Barbatronic/Omni-RC-Robot/mcad/propulsion-arm-asm.FCStd

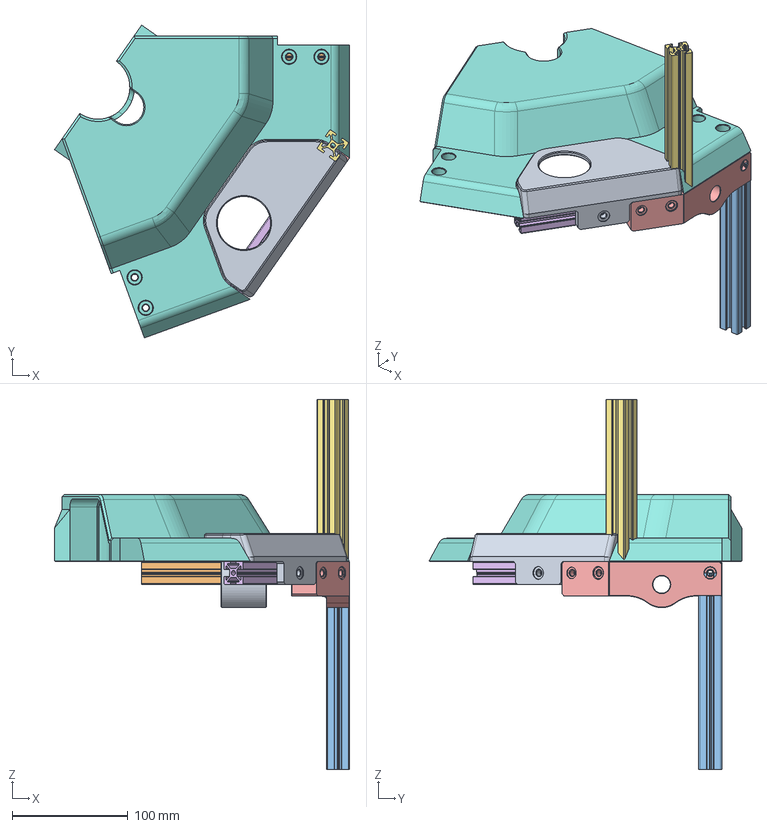
[picture p1: CAD file, 2026-11-05]
mcad/propulsion-arm-asm.FCStd
255.2 x 270.5 x 320.0 mm
motor-flange
Frame_Sketch005_Edge1
frame_Sketch005_Edge1
motor-bride
bearing-flange-link
Frame_Sketch038_Edge1
frame_Sketch038_Edge1
Carter
