Barbatronic/Omni-RC-Robot/mcad/aru-asm.FCStd

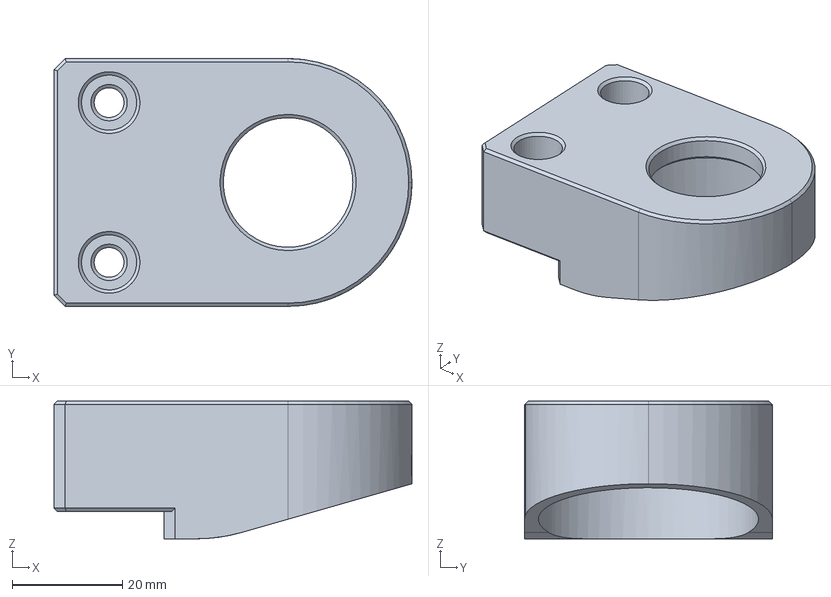
[picture p2: CAD file, 2026-11-05]
mcad/aru-asm.FCStd
65.0 x 45.0 x 25.0 mm
