Barbatronic/Omni-RC-Robot/mcad/propulsion-arm-asm-PièceCorps.3mf.step

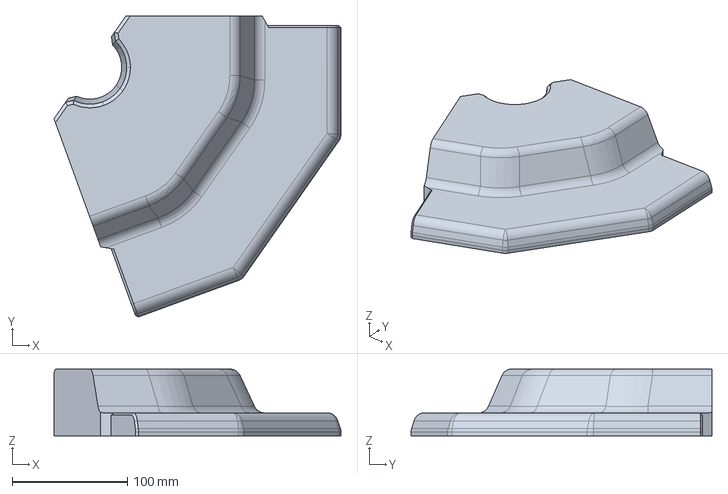
[picture p3: CAD file, 2026-11-05]
mcad/propulsion-arm-asm-PièceCorps.3mf.step
248.6 x 260.6 x 58.0 mm
