Barbatronic/Omni-RC-Robot/mcad/omni-rc-robot.FCStd

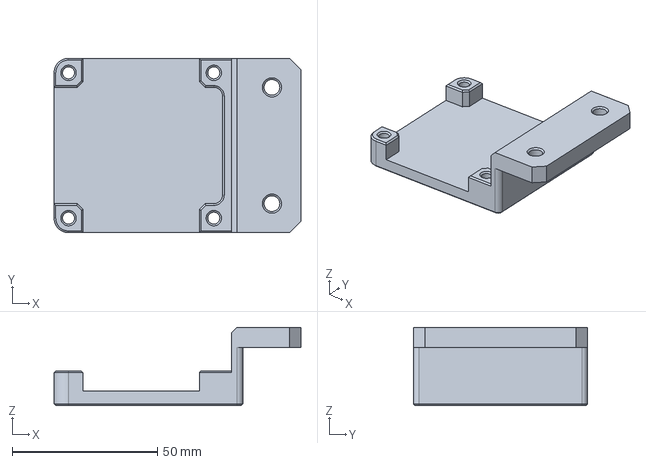
[picture p4: CAD file, 2026-11-05]
mcad/omni-rc-robot.FCStd
85.0 x 60.0 x 27.0 mm
