Barbatronic/Omni-RC-Robot/mcad/battery.FCStd

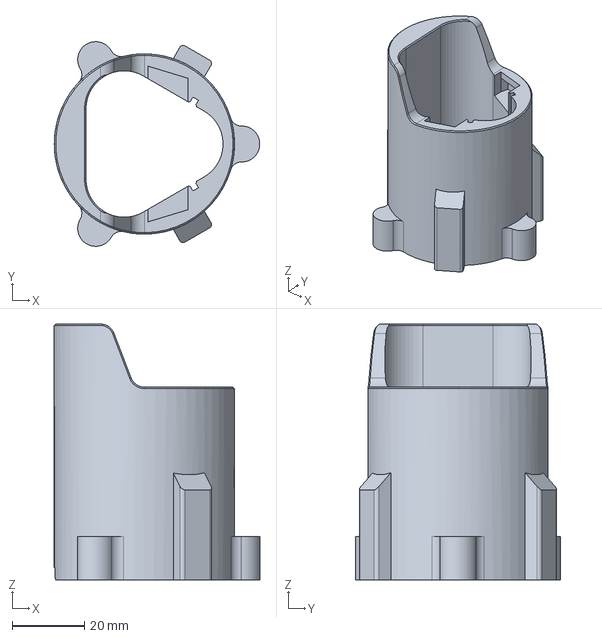
[picture p5: CAD file, 2026-11-05]
mcad/battery.FCStd
57.0 x 56.8 x 71.0 mm
