Barbatronic/Omni-RC-Robot/mcad/motor-hub.FCStd

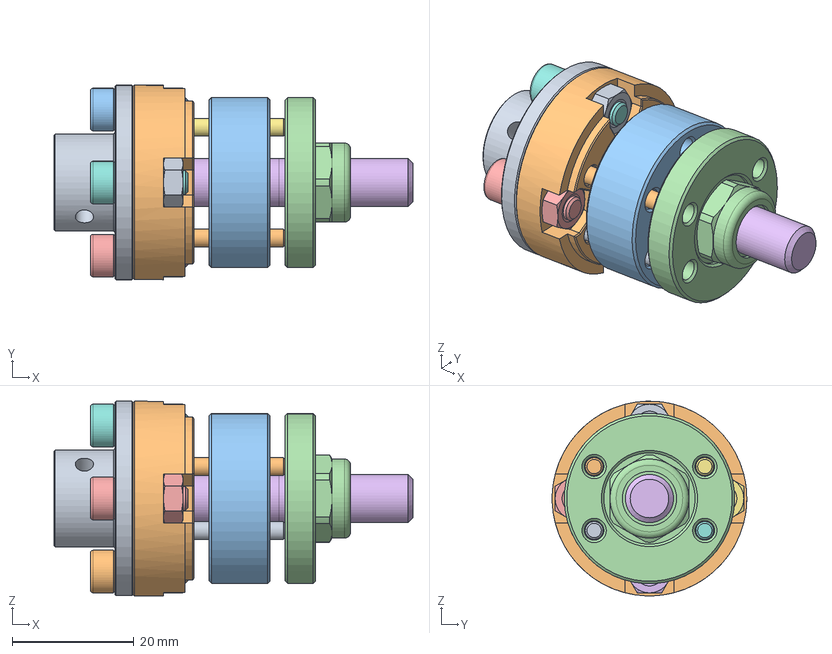
[picture p6: CAD file, 2026-11-05]
mcad/motor-hub.FCStd
59.0 x 32.0 x 32.0 mm
hub-8mm
Corps
Spacer
Corps001
M4x12-Vis002 x 2
M4-Écrous006 x 2
M4-Écrous004 x 2
M3x25-Vis008 x 2
M3x25-Vis007 x 2
M4x12-Vis003 x 2
M4x12-Vis x 2
M8-Écrous x 2
M4-Écrous005 x 2
M8x40-Vis x 2
M3x25-Vis009 x 2
M4x12-Vis001 x 2
M4-Écrous x 2
M3x25-Vis x 2
