Barbatronic/Omni-RC-Robot/mcad/omni-wheel.FCStd

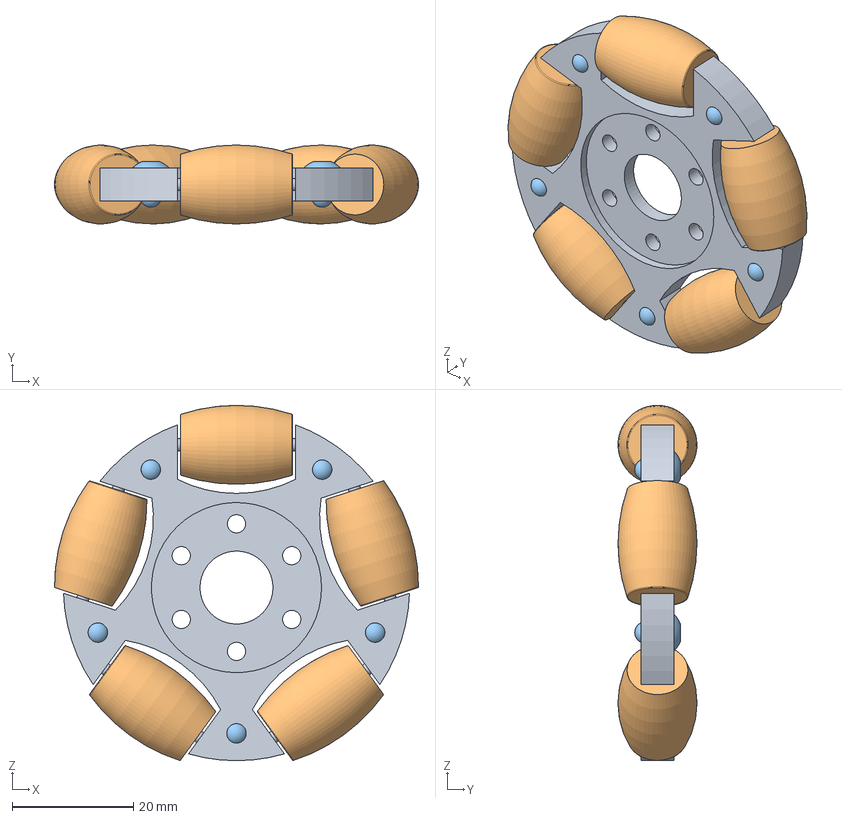
[picture p7: CAD file, 2026-11-05]
mcad/omni-wheel.FCStd
59.9 x 13.0 x 58.5 mm
MainPlate
Roller x 5
Rivet x 5
