Barbatronic/Omni-RC-Robot/mcad/motor-36GP-555.FCStd

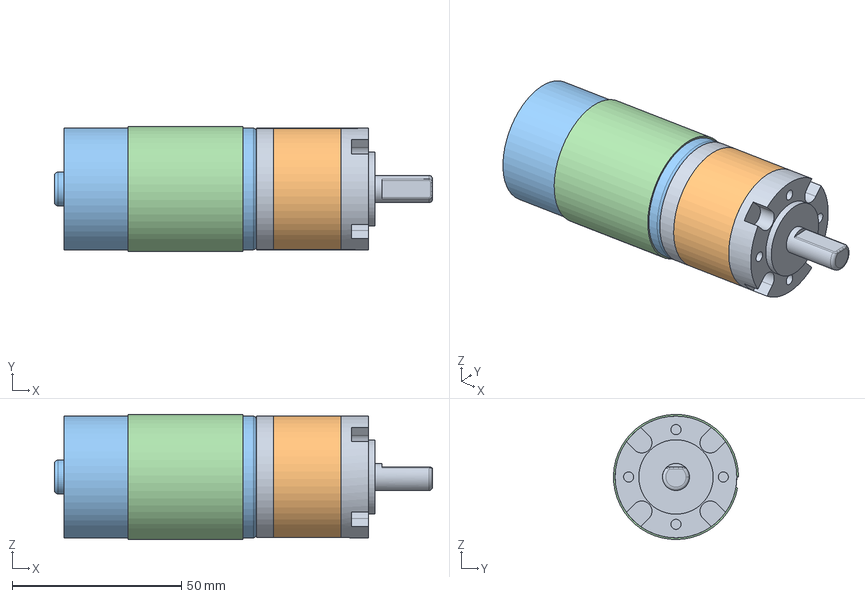
[picture p8: CAD file, 2026-11-05]
mcad/motor-36GP-555.FCStd
111.8 x 37.0 x 37.0 mm
Corps
Corps001
Corps002
Corps003
