Barbatronic/Omni-RC-Robot/mcad/support-BTS7960B.FCStd

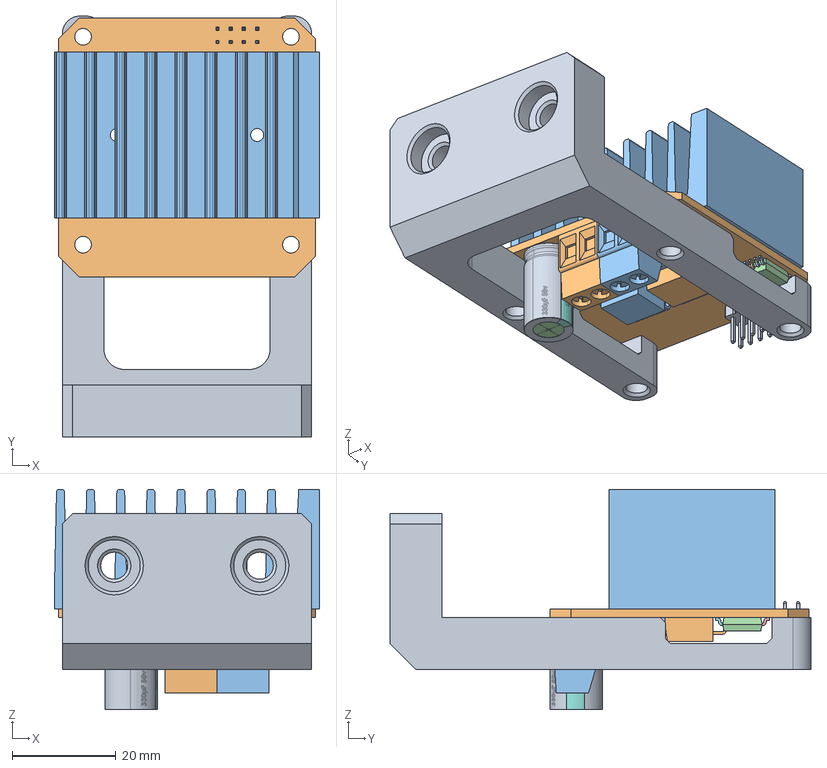
[picture p9: CAD file, 2026-11-05]
mcad/support-BTS7960B.FCStd
51.0 x 81.0 x 42.4 mm
support
PCB, BTS7960 43A HIGH POWER H BRIDGE MODULE
HEATSINK, BTS7960 43A HIGH POWER H BRIDGE MODULE
ALUMINUM ELECTROLYTIC CAPACITOR, 330 uF, BTS7960 43A HIGH POWER H BRIDGE MODULE
ALUMINUM ELECTROLYTIC CAPACITOR, 330 uF, BTS7960 43A HIGH POWER H BRIDGE MODULE001
ALUMINUM ELECTROLYTIC CAPACITOR, 330 uF, BTS7960 43A HIGH POWER H BRIDGE MODULE002
ALUMINUM ELECTROLYTIC CAPACITOR, 330 uF, BTS7960 43A HIGH POWER H BRIDGE MODULE003
ALUMINUM ELECTROLYTIC CAPACITOR, 330 uF, BTS7960 43A HIGH POWER H BRIDGE MODULE004
ALUMINUM ELECTROLYTIC CAPACITOR, 330 uF, BTS7960 43A HIGH POWER H BRIDGE MODULE005
BTN7960 IC, BTS7960 43A HIGH POWER H BRIDGE MODULE
BTN7960 IC, BTS7960 43A HIGH POWER H BRIDGE MODULE001
BTN7960 IC, BTS7960 43A HIGH POWER H BRIDGE MODULE002
BTN7960 IC, BTS7960 43A HIGH POWER H BRIDGE MODULE003
BTN7960 IC, BTS7960 43A HIGH POWER H BRIDGE MODULE004
BTN7960 IC, BTS7960 43A HIGH POWER H BRIDGE MODULE005
BTN7960 IC, BTS7960 43A HIGH POWER H BRIDGE MODULE006
BTN7960 IC, BTS7960 43A HIGH POWER H BRIDGE MODULE007
BTN7960 IC, BTS7960 43A HIGH POWER H BRIDGE MODULE008
BTN7960 IC, BTS7960 43A HIGH POWER H BRIDGE MODULE010
BTN7960 IC, BTS7960 43A HIGH POWER H BRIDGE MODULE011
BTN7960 IC, BTS7960 43A HIGH POWER H BRIDGE MODULE012
BTN7960 IC, BTS7960 43A HIGH POWER H BRIDGE MODULE013
BTN7960 IC, BTS7960 43A HIGH POWER H BRIDGE MODULE014
BTN7960 IC, BTS7960 43A HIGH POWER H BRIDGE MODULE015
BTN7960 IC, BTS7960 43A HIGH POWER H BRIDGE MODULE016
BTN7960 IC, BTS7960 43A HIGH POWER H BRIDGE MODULE017
BTN7960 IC, BTS7960 43A HIGH POWER H BRIDGE MODULE018
NXP 74HC244D, BUFFER AND LINE DRIVER, BTS7960 43A HIGH POWER H BRIDGE MODULE
NXP 74HC244D, BUFFER AND LINE DRIVER, BTS7960 43A HIGH POWER H BRIDGE MODULE001
NXP 74HC244D, BUFFER AND LINE DRIVER, BTS7960 43A HIGH POWER H BRIDGE MODULE002
NXP 74HC244D, BUFFER AND LINE DRIVER, BTS7960 43A HIGH POWER H BRIDGE MODULE003
NXP 74HC244D, BUFFER AND LINE DRIVER, BTS7960 43A HIGH POWER H BRIDGE MODULE004
NXP 74HC244D, BUFFER AND LINE DRIVER, BTS7960 43A HIGH POWER H BRIDGE MODULE005
NXP 74HC244D, BUFFER AND LINE DRIVER, BTS7960 43A HIGH POWER H BRIDGE MODULE006
NXP 74HC244D, BUFFER AND LINE DRIVER, BTS7960 43A HIGH POWER H BRIDGE MODULE007
NXP 74HC244D, BUFFER AND LINE DRIVER, BTS7960 43A HIGH POWER H BRIDGE MODULE008
NXP 74HC244D, BUFFER AND LINE DRIVER, BTS7960 43A HIGH POWER H BRIDGE MODULE009
NXP 74HC244D, BUFFER AND LINE DRIVER, BTS7960 43A HIGH POWER H BRIDGE MODULE010
NXP 74HC244D, BUFFER AND LINE DRIVER, BTS7960 43A HIGH POWER H BRIDGE MODULE011
NXP 74HC244D, BUFFER AND LINE DRIVER, BTS7960 43A HIGH POWER H BRIDGE MODULE012
NXP 74HC244D, BUFFER AND LINE DRIVER, BTS7960 43A HIGH POWER H BRIDGE MODULE013
NXP 74HC244D, BUFFER AND LINE DRIVER, BTS7960 43A HIGH POWER H BRIDGE MODULE014
NXP 74HC244D, BUFFER AND LINE DRIVER, BTS7960 43A HIGH POWER H BRIDGE MODULE015
NXP 74HC244D, BUFFER AND LINE DRIVER, BTS7960 43A HIGH POWER H BRIDGE MODULE016
NXP 74HC244D, BUFFER AND LINE DRIVER, BTS7960 43A HIGH POWER H BRIDGE MODULE017
NXP 74HC244D, BUFFER AND LINE DRIVER, BTS7960 43A HIGH POWER H BRIDGE MODULE018
NXP 74HC244D, BUFFER AND LINE DRIVER, BTS7960 43A HIGH POWER H BRIDGE MODULE019
NXP 74HC244D, BUFFER AND LINE DRIVER, BTS7960 43A HIGH POWER H BRIDGE MODULE020
8 PIN HEADER, IC, BTS7960 43A HIGH POWER H BRIDGE MODULE
EUROSTYLE TERMINAL BLOCK 2 POS 5.0 MM RA PLUG, BTS7960 43A HIGH POWER H BRIDGE MODULE
EUROSTYLE TERMINAL BLOCK 2 POS 5.0 MM RA PLUG, BTS7960 43A HIGH POWER H BRIDGE MODULE001
