Barbatronic/Omni-RC-Robot/ecad/omni-board/omni-board.kicad_pcb

## KiCad design ecad/omni-board/omni-board.kicad_pcb (2026-09-16)

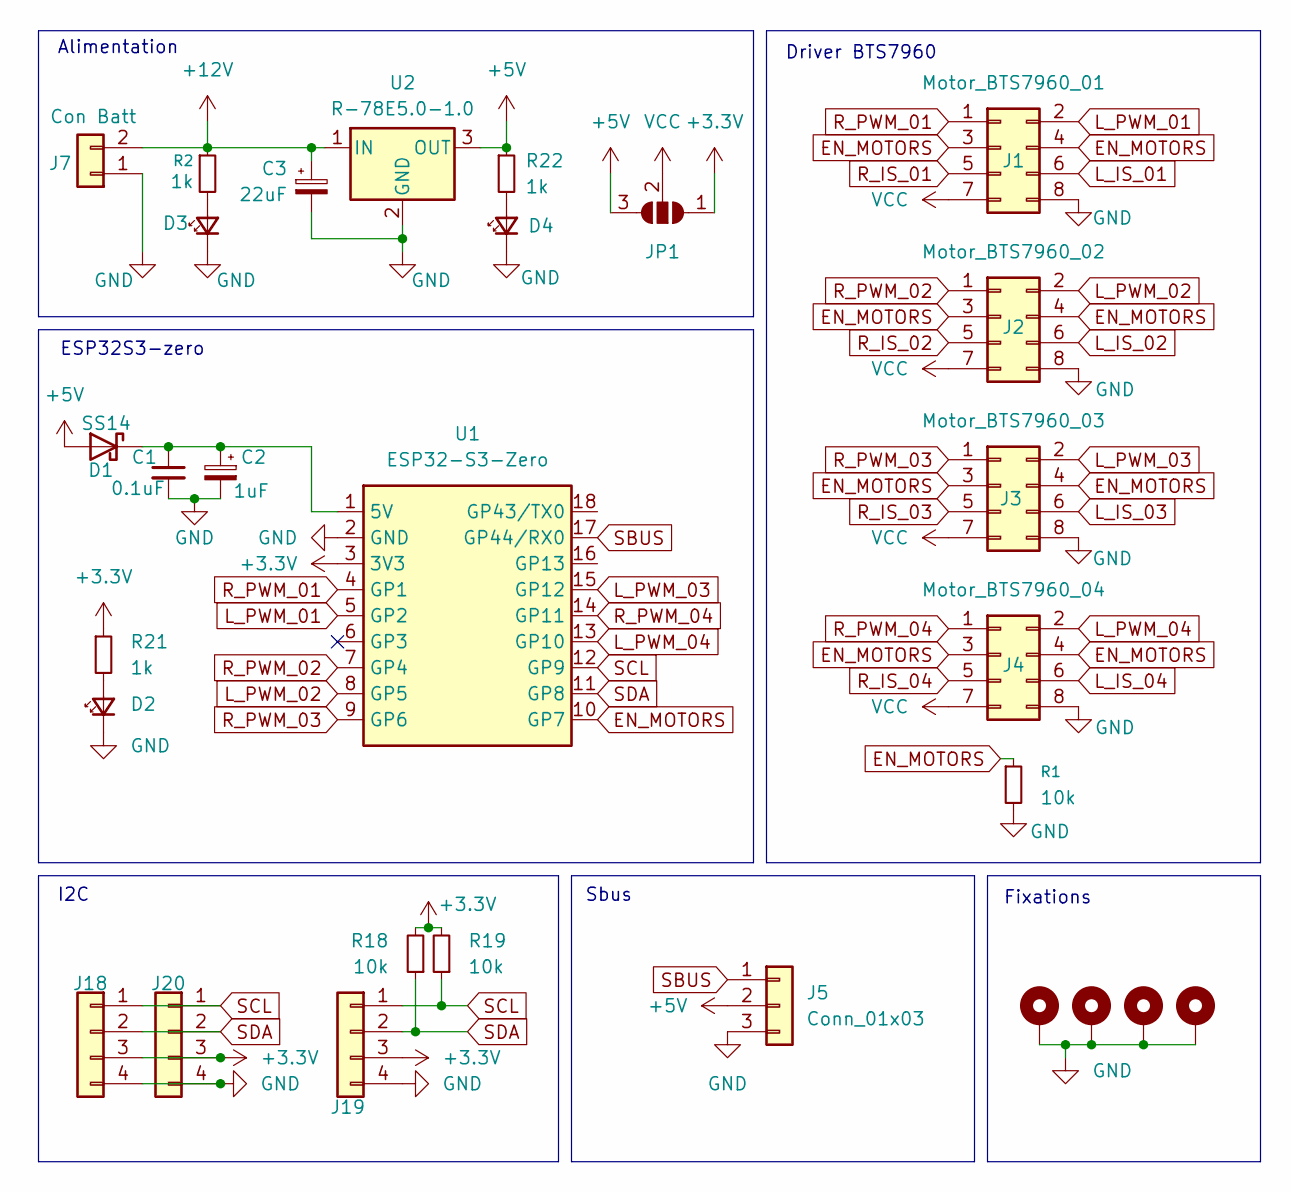
[picture p10: schematic omni-board.kicad_sch]

Parts:
C1: 0.1uF; C_1206_3216Metric_Pad1.33x1.80mm_HandSolder
C2: 1uF; CP_Elec_5x5.4
C3: 22uF; CP_Elec_5x5.4
D1: SS14; D_SMA_Handsoldering
D2, D3, D4: LED_Small; LED_1206_3216Metric_Pad1.42x1.75mm_HandSolder
H1, H2, H3, H4: MountingHole_Pad; MountingHole_3.2mm_M3_Pad_Via
J1: Motor_BTS7960_01; IDC-Header_2x04_P2.54mm_Vertical
J2: Motor_BTS7960_02; IDC-Header_2x04_P2.54mm_Vertical
J3: Motor_BTS7960_03; IDC-Header_2x04_P2.54mm_Vertical
J4: Motor_BTS7960_04; IDC-Header_2x04_P2.54mm_Vertical
J5: Conn_01x03; PinHeader_1x03_P2.54mm_Vertical
J7: Con Batt; AMASS_XT60-M_1x02_P7.20mm_Vertical
J18, J19, J20: Conn_01x04; Molex_KK-254_AE-6410-04A_1x04_P2.54mm_Vertical
JP1: SolderJumper_3_Open; SolderJumper-3_P2.0mm_Open_TrianglePad1.0x1.5mm
R1, R18, R19: 10k; R_1206_3216Metric_Pad1.30x1.75mm_HandSolder
R2, R21, R22: 1k; R_1206_3216Metric_Pad1.30x1.75mm_HandSolder
U1: ESP32-S3-Zero; ESP32-S3-Zero_THT; MPN ESP32-S3-Zero
U2: R-78E5.0-1.0; Converter_DCDC_RECOM_R-78E-0.5_THT

Connections:
+3.3V: J18.3, J19.3, J20.3, JP1.1 (A), R18.2, R19.2, R21.1, U1.3 (3V3)
+5V: D1.2 (A), J5.2, JP1.3 (B), R22.1, U2.3 (OUT)
+12V: C3.1, J7.2, R2.1, U2.1 (IN)
EN_MOTORS: J1.3, J1.4, J2.3, J2.4, J3.3, J3.4, J4.3, J4.4, R1.1, U1.10 (GP7)
GND: C1.2, C2.2, C3.2, D2.1 (K), D3.1 (K), D4.1 (K), H1.1 (1_1), H2.1 (1_1), H3.1 (1_1), H4.1 (1_1), J1.8, J2.8, J3.8, J4.8, J5.3, J7.1, J18.4, J19.4, J20.4, R1.2, U1.2 (GND), U2.2 (GND)
L_IS_01: J1.6
L_IS_02: J2.6
L_IS_03: J3.6
L_IS_04: J4.6
L_PWM_01: J1.2, U1.5 (GP2)
L_PWM_02: J2.2, U1.8 (GP5)
L_PWM_03: J3.2, U1.15 (GP12)
L_PWM_04: J4.2, U1.13 (GP10)
unnamed: C1.1, C2.1, D1.1 (K), U1.1 (5V)
unnamed: D2.2 (A), R21.2
unnamed: D3.2 (A), R2.2
unnamed: D4.2 (A), R22.2
R_IS_01: J1.5
R_IS_02: J2.5
R_IS_03: J3.5
R_IS_04: J4.5
R_PWM_01: J1.1, U1.4 (GP1)
R_PWM_02: J2.1, U1.7 (GP4)
R_PWM_03: J3.1, U1.9 (GP6)
R_PWM_04: J4.1, U1.14 (GP11)
SBUS: J5.1, U1.17 (GP44/RX0)
SCL: J18.1, J19.1, J20.1, R19.1, U1.12 (GP9)
SDA: J18.2, J19.2, J20.2, R18.1, U1.11 (GP8)
VCC: J1.7, J2.7, J3.7, J4.7, JP1.2 (C)

Notes on the sheet:
Fixations
Driver BTS7960
Sbus
ESP32S3-zero
Alimentation
I2C

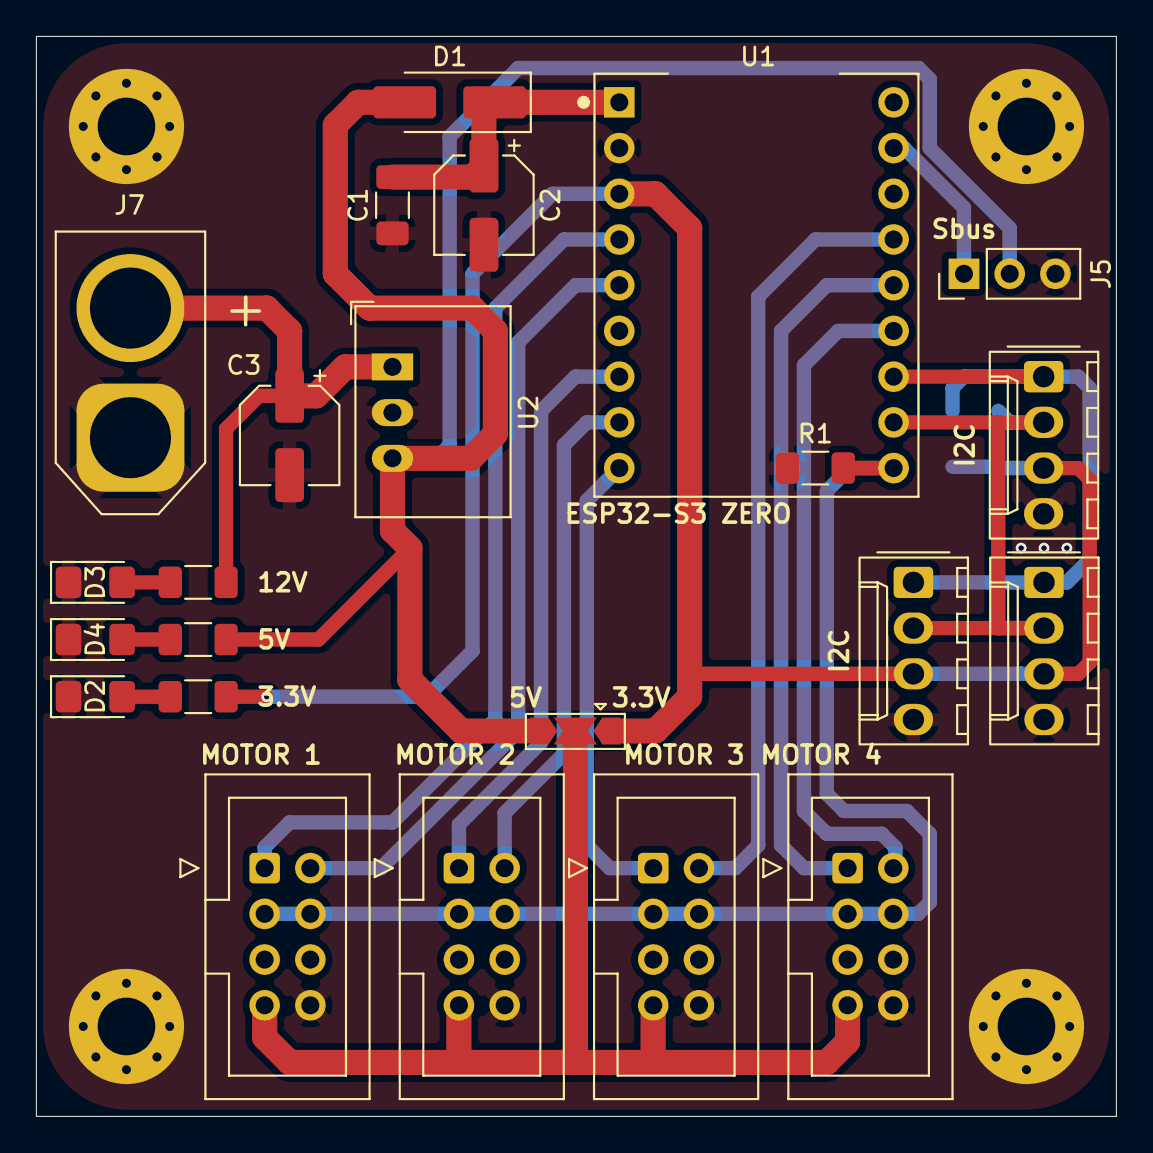
[picture p11: board omni-board.kicad_pcb from above]

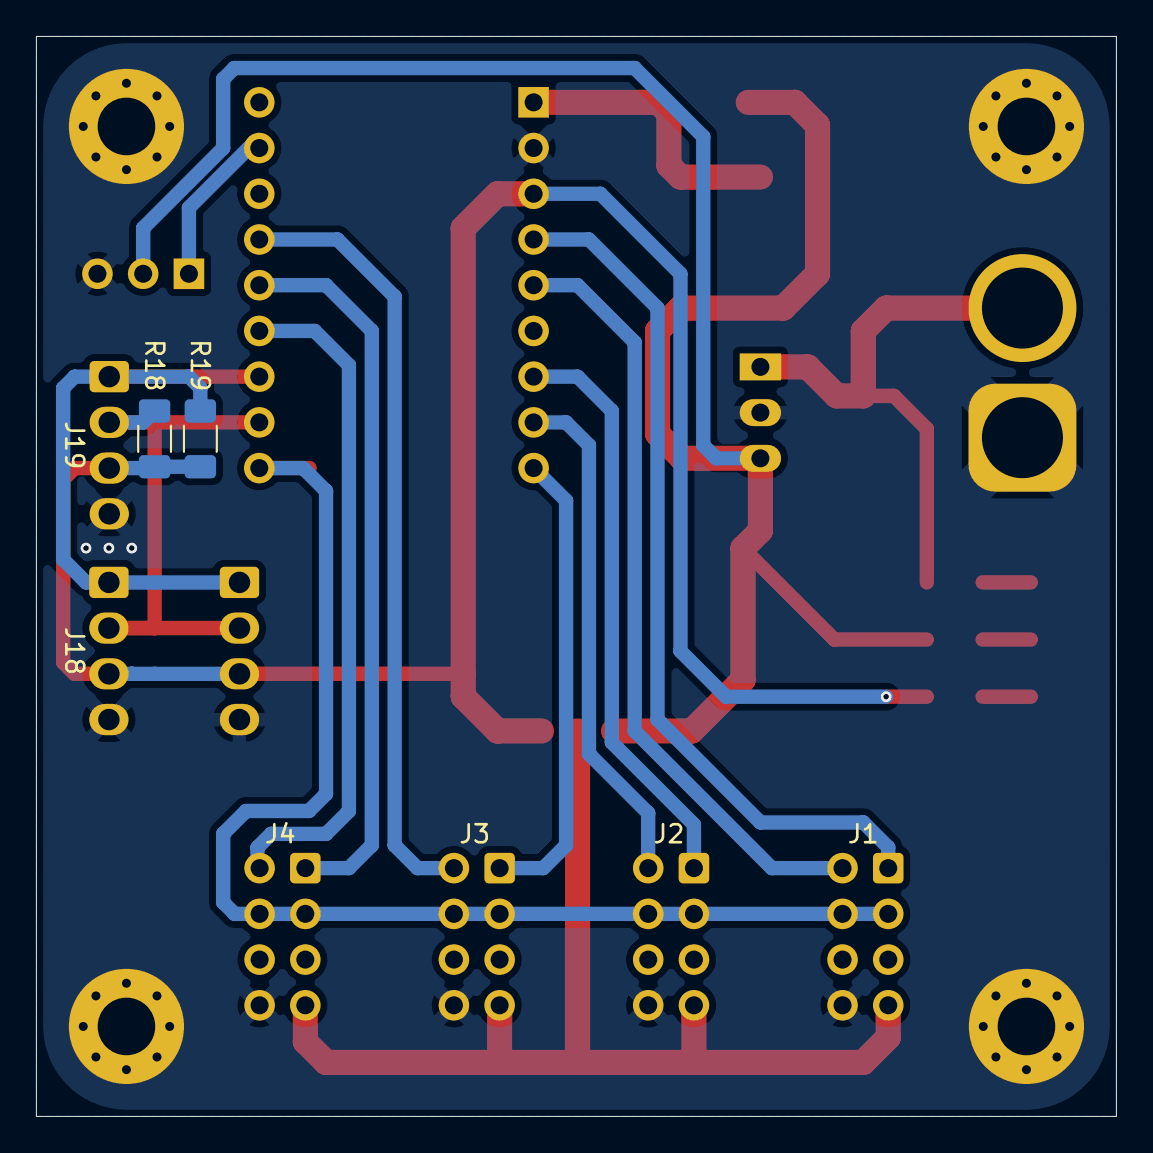
[picture p12: board omni-board.kicad_pcb from below]

Board: 2 copper layers, 60.0 x 60.0 mm, 29 parts (2 on the bottom side), 21 nets.
