Barbatronic/Omni-RC-Robot/mcad/.snapshots/motor-hub.yaml

v: 2
timestamp: '2026-08-29T11:19:20.004278'
uid: 6a041699-94d3-48be-af7a-7bac7a8adb73
objects:
- name: Body
  id: 1631
  type_id: PartDesign::Body
  properties:
    AllowCompound:
      kind: Primitive
      paths:
        .:
          type: BOOL
          value: true
      group: Base
    BaseFeature:
      kind: Primitive
      paths:
        .:
          type: 'NULL'
      group: Base
    Label:
      kind: Primitive
      paths:
        .:
          type: STRING
          value: hub-8mm
      group: Base
    Placement:
      kind: Placement
      paths:
        Base.x:
          type: QUANTITY
          value: 0.0 mm
        Base.y:
          type: QUANTITY
          value: 0.0 mm
        Base.z:
          type: QUANTITY
          value: 0.0 mm
        Rotation.Angle:
          type: QUANTITY
          value: 0.0 deg
        Rotation.Axis.x:
          type: FLOAT
          value: 0.0
        Rotation.Axis.y:
          type: FLOAT
          value: 0.0
        Rotation.Axis.z:
          type: FLOAT
          value: 1.0
      group: Base
    Tip:
      kind: Unknown
      paths:
        .:
          type: STRING
          value: <PartDesign::Chamfer>
          freecad_type: PartDesign.Feature
      group: Base
- name: Origin
  id: 1632
  type_id: App::Origin
  properties:
    Label:
      kind: Primitive
      paths:
        .:
          type: STRING
          value: Origine
      group: Base
- name: X_Axis
  id: 1633
  type_id: App::Line
  properties:
    Label:
      kind: Primitive
      paths:
        .:
          type: STRING
          value: Axe X
      group: Base
- name: Y_Axis
  id: 1634
  type_id: App::Line
  properties:
    Label:
      kind: Primitive
      paths:
        .:
          type: STRING
          value: Axe Y
      group: Base
- name: Z_Axis
  id: 1635
  type_id: App::Line
  properties:
    Label:
      kind: Primitive
      paths:
        .:
          type: STRING
          value: Axe Z
      group: Base
- name: XY_Plane
  id: 1636
  type_id: App::Plane
  properties:
    Label:
      kind: Primitive
      paths:
        .:
          type: STRING
          value: Plan XY
      group: Base
- name: XZ_Plane
  id: 1637
  type_id: App::Plane
  properties:
    Label:
      kind: Primitive
      paths:
        .:
          type: STRING
          value: Plan XZ
      group: Base
- name: YZ_Plane
  id: 1638
  type_id: App::Plane
  properties:
    Label:
      kind: Primitive
      paths:
        .:
          type: STRING
          value: Plan YZ
      group: Base
- name: Origin001
  id: 1639
  type_id: App::Point
  properties:
    Label:
      kind: Primitive
      paths:
        .:
          type: STRING
          value: Origine-point
      group: Base
- name: Sketch
  id: 1641
  type_id: Sketcher::SketchObject
  properties:
    ArcFitTolerance:
      kind: Primitive
      paths:
        .:
          type: FLOAT
          value: 1.0e-06
      group: Sketch
    AttacherEngine:
      kind: Primitive
      paths:
        .:
          type: STRING
          value: Engine Plane
      group: Attachment
    AttachmentOffset:
      kind: Placement
      paths:
        Base.x:
          type: QUANTITY
          value: 0.0 mm
        Base.y:
          type: QUANTITY
          value: 0.0 mm
        Base.z:
          type: QUANTITY
          value: 0.0 mm
        Rotation.Angle:
          type: QUANTITY
          value: 0.0 deg
        Rotation.Axis.x:
          type: FLOAT
          value: 0.0
        Rotation.Axis.y:
          type: FLOAT
          value: 0.0
        Rotation.Axis.z:
          type: FLOAT
          value: 1.0
      group: Attachment
    Constraints:
      kind: List
      paths: {}
      items:
      - kind: Constraint
        paths:
          Type:
            type: STRING
            value: PointOnObject
          Value:
            type: FLOAT
            value: 0.0
          First:
            type: INT
            value: 0
          FirstPos:
            type: INT
            value: 1
          Second:
            type: INT
            value: -1
          SecondPos:
            type: INT
            value: 0
          Third:
            type: INT
            value: -2000
          ThirdPos:
            type: INT
            value: 0
          Driving:
            type: BOOL
            value: true
          IsActive:
            type: BOOL
            value: true
      - kind: Constraint
        paths:
          Type:
            type: STRING
            value: Vertical
          Value:
            type: FLOAT
            value: 0.0
          First:
            type: INT
            value: 0
          FirstPos:
            type: INT
            value: 0
          Second:
            type: INT
            value: -2000
          SecondPos:
            type: INT
            value: 0
          Third:
            type: INT
            value: -2000
          ThirdPos:
            type: INT
            value: 0
          Driving:
            type: BOOL
            value: true
          IsActive:
            type: BOOL
            value: true
      - kind: Constraint
        paths:
          Type:
            type: STRING
            value: Coincident
          Value:
            type: FLOAT
            value: 0.0
          First:
            type: INT
            value: 0
          FirstPos:
            type: INT
            value: 2
          Second:
            type: INT
            value: 1
          SecondPos:
            type: INT
            value: 1
          Third:
            type: INT
            value: -2000
          ThirdPos:
            type: INT
            value: 0
          Driving:
            type: BOOL
            value: true
          IsActive:
            type: BOOL
            value: true
      - kind: Constraint
        paths:
          Type:
            type: STRING
            value: Horizontal
          Value:
            type: FLOAT
            value: 0.0
          First:
            type: INT
            value: 1
          FirstPos:
            type: INT
            value: 0
          Second:
            type: INT
            value: -2000
          SecondPos:
            type: INT
            value: 0
          Third:
            type: INT
            value: -2000
          ThirdPos:
            type: INT
            value: 0
          Driving:
            type: BOOL
            value: true
          IsActive:
            type: BOOL
            value: true
      - kind: Constraint
        paths:
          Type:
            type: STRING
            value: Coincident
          Value:
            type: FLOAT
            value: 0.0
          First:
            type: INT
            value: 1
          FirstPos:
            type: INT
            value: 2
          Second:
            type: INT
            value: 2
          SecondPos:
            type: INT
            value: 1
          Third:
            type: INT
            value: -2000
          ThirdPos:
            type: INT
            value: 0
          Driving:
            type: BOOL
            value: true
          IsActive:
            type: BOOL
            value: true
      - kind: Constraint
        paths:
          Type:
            type: STRING
            value: Vertical
          Value:
            type: FLOAT
            value: 0.0
          First:
            type: INT
            value: 2
          FirstPos:
            type: INT
            value: 0
          Second:
            type: INT
            value: -2000
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
            value: 0
          Driving:
            type: BOOL
            value: true
          IsActive:
            type: BOOL
            value: true
      group: Sketch
    Label:
      kind: Primitive
      paths:
        .:
          type: STRING
          value: Sketch
      group: Base
    MakeInternals:
      kind: Primitive
      paths:
        .:
          type: BOOL
          value: true
      group: Internal Geometry
    MapMode:
      kind: Primitive
      paths:
        .:
          type: STRING
          value: FlatFace
      group: Attachment
    MapReversed:
      kind: Primitive
      paths:
        .:
          type: BOOL
          value: false
      group: Attachment
    Placement:
      kind: Placement
      paths:
        Base.x:
          type: QUANTITY
          value: 0.0 mm
        Base.y:
          type: QUANTITY
          value: 0.0 mm
        Base.z:
          type: QUANTITY
          value: 0.0 mm
        Rotation.Angle:
          type: QUANTITY
          value: 90.0 deg
        Rotation.Axis.x:
          type: FLOAT
          value: 1.0
        Rotation.Axis.y:
          type: FLOAT
          value: 0.0
        Rotation.Axis.z:
          type: FLOAT
          value: 0.0
      group: Base
- name: Revolution
  id: 1642
  type_id: PartDesign::Revolution
  properties:
    AllowMultiFace:
      kind: Primitive
      paths:
        .:
          type: BOOL
          value: true
      group: SketchBased
    Angle:
      kind: Primitive
      paths:
        .:
          type: QUANTITY
          value: 360.0 deg
      group: Side1
    Angle2:
      kind: Primitive
      paths:
        .:
          type: QUANTITY
          value: 0.0 deg
      group: Side2
    FuzzyTolerance:
      kind: Primitive
      paths:
        .:
          type: FLOAT
          value: 0.0
      group: Part Design
    Label:
      kind: Primitive
      paths:
        .:
          type: STRING
          value: Revolution
      group: Base
    Midplane:
      kind: Primitive
      paths:
        .:
          type: BOOL
          value: false
      group: SketchBased
    Profile:
      kind: List
      paths: {}
      items:
      - kind: Unknown
        paths:
          .:
            type: STRING
            value: <Sketcher::SketchObject>
            freecad_type: Sketcher.SketchObject
      - kind: List
        paths: {}
        items:
        - kind: Primitive
          paths:
            .:
              type: STRING
              value: ''
      group: SketchBased
    ReferenceAxis:
      kind: List
      paths: {}
      items:
      - kind: Unknown
        paths:
          .:
            type: STRING
            value: <Sketcher::SketchObject>
            freecad_type: Sketcher.SketchObject
      - kind: List
        paths: {}
        items:
        - kind: Primitive
          paths:
            .:
              type: STRING
              value: H_Axis
      group: Revolution
    Refine:
      kind: Primitive
      paths:
        .:
          type: BOOL
          value: true
      group: Part Design
    Reversed:
      kind: Primitive
      paths:
        .:
          type: BOOL
          value: false
      group: SketchBased
    SideType:
      kind: Primitive
      paths:
        .:
          type: STRING
          value: One side
      group: Revolution
    Suppressed:
      kind: Primitive
      paths:
        .:
          type: BOOL
          value: false
      group: Base
    Type:
      kind: Primitive
      paths:
        .:
          type: STRING
          value: Angle
      group: Side1
    Type2:
      kind: Primitive
      paths:
        .:
          type: STRING
          value: Angle
      group: Side2
    UpToFace:
      kind: Primitive
      paths:
        .:
          type: 'NULL'
      group: Side1
    UpToFace2:
      kind: Primitive
      paths:
        .:
          type: 'NULL'
      group: Side2
- name: Sketch001
  id: 1643
  type_id: Sketcher::SketchObject
  properties:
    ArcFitTolerance:
      kind: Primitive
      paths:
        .:
          type: FLOAT
          value: 1.0e-06
      group: Sketch
    AttacherEngine:
      kind: Primitive
      paths:
        .:
          type: STRING
          value: Engine Plane
      group: Attachment
    AttachmentOffset:
      kind: Placement
      paths:
        Base.x:
          type: QUANTITY
          value: 0.0 mm
        Base.y:
          type: QUANTITY
          value: 0.0 mm
        Base.z:
          type: QUANTITY
          value: 0.0 mm
        Rotation.Angle:
          type: QUANTITY
          value: 0.0 deg
        Rotation.Axis.x:
          type: FLOAT
          value: 0.0
        Rotation.Axis.y:
          type: FLOAT
          value: 0.0
        Rotation.Axis.z:
          type: FLOAT
          value: 1.0
      group: Attachment
    Constraints:
      kind: List
      paths: {}
      items:
      - kind: Constraint
        paths:
          Type:
            type: STRING
            value: PointOnObject
          Value:
            type: FLOAT
            value: 0.0
          First:
            type: INT
            value: 0
          FirstPos:
            type: INT
            value: 3
          Second:
            type: INT
            value: -2
          SecondPos:
            type: INT
            value: 0
          Third:
            type: INT
            value: -2000
          ThirdPos:
            type: INT
            value: 0
          Driving:
            type: BOOL
            value: true
          IsActive:
            type: BOOL
            value: true
      - kind: Constraint
        paths:
          Type:
            type: STRING
            value: Diameter
          Value:
            type: FLOAT
            value: 4.0
          First:
            type: INT
            value: 0
          FirstPos:
            type: INT
            value: 0
          Second:
            type: INT
            value: -2000
          SecondPos:
            type: INT
            value: 0
          Third:
            type: INT
            value: -2000
          ThirdPos:
            type: INT
            value: 0
          Driving:
            type: BOOL
            value: true
          IsActive:
            type: BOOL
            value: true
      - kind: Constraint
        paths:
          Type:
            type: STRING
            value: DistanceY
          Value:
            type: FLOAT
            value: 12.0
          First:
            type: INT
            value: -1
          FirstPos:
            type: INT
            value: 1
          Second:
            type: INT
            value: 0
          SecondPos:
            type: INT
            value: 3
          Third:
            type: INT
            value: -2000
          ThirdPos:
            type: INT
            value: 0
          Driving:
            type: BOOL
            value: true
          IsActive:
            type: BOOL
            value: true
      group: Sketch
    Label:
      kind: Primitive
      paths:
        .:
          type: STRING
          value: Sketch001
      group: Base
    MakeInternals:
      kind: Primitive
      paths:
        .:
          type: BOOL
          value: true
      group: Internal Geometry
    MapMode:
      kind: Primitive
      paths:
        .:
          type: STRING
          value: FlatFace
      group: Attachment
    MapReversed:
      kind: Primitive
      paths:
        .:
          type: BOOL
          value: false
      group: Attachment
    Placement:
      kind: Placement
      paths:
        Base.x:
          type: QUANTITY
          value: 0.0 mm
        Base.y:
          type: QUANTITY
          value: 0.0 mm
        Base.z:
          type: QUANTITY
          value: 0.0 mm
        Rotation.Angle:
          type: QUANTITY
          value: 120.00000000000001 deg
        Rotation.Axis.x:
          type: FLOAT
          value: 0.5773502691896257
        Rotation.Axis.y:
          type: FLOAT
          value: 0.5773502691896257
        Rotation.Axis.z:
          type: FLOAT
          value: 0.5773502691896257
      group: Base
- name: Pocket
  id: 1644
  type_id: PartDesign::Pocket
  properties:
    AllowMultiFace:
      kind: Primitive
      paths:
        .:
          type: BOOL
          value: true
      group: SketchBased
    AlongSketchNormal:
      kind: Primitive
      paths:
        .:
          type: BOOL
          value: true
      group: Pocket
    FuzzyTolerance:
      kind: Primitive
      paths:
        .:
          type: FLOAT
          value: 0.0
      group: Part Design
    Label:
      kind: Primitive
      paths:
        .:
          type: STRING
          value: Pocket
      group: Base
    Length:
      kind: Primitive
      paths:
        .:
          type: QUANTITY
          value: 5.0 mm
      group: Side1
    Length2:
      kind: Primitive
      paths:
        .:
          type: QUANTITY
          value: 5.0 mm
      group: Side2
    Midplane:
      kind: Primitive
      paths:
        .:
          type: BOOL
          value: false
      group: SketchBased
    Offset:
      kind: Primitive
      paths:
        .:
          type: QUANTITY
          value: 0.0 mm
      group: Side1
    Offset2:
      kind: Primitive
      paths:
        .:
          type: QUANTITY
          value: 0.0 mm
      group: Side2
    Profile:
      kind: List
      paths: {}
      items:
      - kind: Unknown
        paths:
          .:
            type: STRING
            value: <Sketcher::SketchObject>
            freecad_type: Sketcher.SketchObject
      - kind: List
        paths: {}
        items:
        - kind: Primitive
          paths:
            .:
              type: STRING
              value: ''
      group: SketchBased
    ReferenceAxis:
      kind: List
      paths: {}
      items:
      - kind: Unknown
        paths:
          .:
            type: STRING
            value: <Sketcher::SketchObject>
            freecad_type: Sketcher.SketchObject
      - kind: List
        paths: {}
        items:
        - kind: Primitive
          paths:
            .:
              type: STRING
              value: N_Axis
      group: Pocket
    Refine:
      kind: Primitive
      paths:
        .:
          type: BOOL
          value: true
      group: Part Design
    Reversed:
      kind: Primitive
      paths:
        .:
          type: BOOL
          value: false
      group: SketchBased
    SideType:
      kind: Primitive
      paths:
        .:
          type: STRING
          value: One side
      group: Pocket
    StartOffset:
      kind: Primitive
      paths:
        .:
          type: QUANTITY
          value: 0.0 mm
      group: Start
    StartReference:
      kind: Primitive
      paths:
        .:
          type: 'NULL'
      group: Start
    StartType:
      kind: Primitive
      paths:
        .:
          type: STRING
          value: Profile plane
      group: Start
    Suppressed:
      kind: Primitive
      paths:
        .:
          type: BOOL
          value: false
      group: Base
    TaperAngle:
      kind: Primitive
      paths:
        .:
          type: QUANTITY
          value: 0.0 deg
      group: Side1
    TaperAngle2:
      kind: Primitive
      paths:
        .:
          type: QUANTITY
          value: 0.0 deg
      group: Side2
    Type:
      kind: Primitive
      paths:
        .:
          type: STRING
          value: Length
      group: Side1
    Type2:
      kind: Primitive
      paths:
        .:
          type: STRING
          value: Length
      group: Side2
    UpToFace:
      kind: Primitive
      paths:
        .:
          type: 'NULL'
      group: Side1
    UpToFace2:
      kind: Primitive
      paths:
        .:
          type: 'NULL'
      group: Side2
    UseCustomVector:
      kind: Primitive
      paths:
        .:
          type: BOOL
          value: false
      group: Pocket
- name: PolarPattern
  id: 1645
  type_id: PartDesign::PolarPattern
  properties:
    Angle:
      kind: Primitive
      paths:
        .:
          type: QUANTITY
          value: 360.0 deg
      group: PolarPattern
    Axis:
      kind: List
      paths: {}
      items:
      - kind: Unknown
        paths:
          .:
            type: STRING
            value: <Sketcher::SketchObject>
            freecad_type: Sketcher.SketchObject
      - kind: List
        paths: {}
        items:
        - kind: Primitive
          paths:
            .:
              type: STRING
              value: N_Axis
      group: PolarPattern
    FuzzyTolerance:
      kind: Primitive
      paths:
        .:
          type: FLOAT
          value: 0.0
      group: Part Design
    Label:
      kind: Primitive
      paths:
        .:
          type: STRING
          value: PolarPattern
      group: Base
    Mode:
      kind: Primitive
      paths:
        .:
          type: STRING
          value: Extent
      group: PolarPattern
    Occurrences:
      kind: Primitive
      paths:
        .:
          type: INT
          value: 4
      group: PolarPattern
    Offset:
      kind: Primitive
      paths:
        .:
          type: QUANTITY
          value: 120.0 deg
      group: PolarPattern
    Refine:
      kind: Primitive
      paths:
        .:
          type: BOOL
          value: true
      group: Part Design
    Reversed:
      kind: Primitive
      paths:
        .:
          type: BOOL
          value: false
      group: PolarPattern
    Suppressed:
      kind: Primitive
      paths:
        .:
          type: BOOL
          value: false
      group: Base
    TransformMode:
      kind: Primitive
      paths:
        .:
          type: STRING
          value: Features
      group: Base
- name: Sketch002
  id: 1646
  type_id: Sketcher::SketchObject
  properties:
    ArcFitTolerance:
      kind: Primitive
      paths:
        .:
          type: FLOAT
          value: 1.0e-06
      group: Sketch
    AttacherEngine:
      kind: Primitive
      paths:
        .:
          type: STRING
          value: Engine Plane
      group: Attachment
    AttachmentOffset:
      kind: Placement
      paths:
        Base.x:
          type: QUANTITY
          value: 0.0 mm
        Base.y:
          type: QUANTITY
          value: 0.0 mm
        Base.z:
          type: QUANTITY
          value: 0.0 mm
        Rotation.Angle:
          type: QUANTITY
          value: 45.00000000000001 deg
        Rotation.Axis.x:
          type: FLOAT
          value: 1.0
        Rotation.Axis.y:
          type: FLOAT
          value: 0.0
        Rotation.Axis.z:
          type: FLOAT
          value: 0.0
      group: Attachment
    Constraints:
      kind: List
      paths: {}
      items:
      - kind: Constraint
        paths:
          Type:
            type: STRING
            value: PointOnObject
          Value:
            type: FLOAT
            value: 0.0
          First:
            type: INT
            value: 0
          FirstPos:
            type: INT
            value: 3
          Second:
            type: INT
            value: -1
          SecondPos:
            type: INT
            value: 0
          Third:
            type: INT
            value: -2000
          ThirdPos:
            type: INT
            value: 0
          Driving:
            type: BOOL
            value: true
          IsActive:
            type: BOOL
            value: true
      - kind: Constraint
        paths:
          Type:
            type: STRING
            value: Distance
          Value:
            type: FLOAT
            value: 5.0
          First:
            type: INT
            value: 0
          FirstPos:
            type: INT
            value: 3
          Second:
            type: INT
            value: -3
          SecondPos:
            type: INT
            value: 0
          Third:
            type: INT
            value: -2000
          ThirdPos:
            type: INT
            value: 0
          Driving:
            type: BOOL
            value: true
          IsActive:
            type: BOOL
            value: true
      - kind: Constraint
        paths:
          Type:
            type: STRING
            value: Diameter
          Value:
            type: FLOAT
            value: 3.0
          First:
            type: INT
            value: 0
          FirstPos:
            type: INT
            value: 0
          Second:
            type: INT
            value: -2000
          SecondPos:
            type: INT
            value: 0
          Third:
            type: INT
            value: -2000
          ThirdPos:
            type: INT
            value: 0
          Driving:
            type: BOOL
            value: true
          IsActive:
            type: BOOL
            value: true
      group: Sketch
    Label:
      kind: Primitive
      paths:
        .:
          type: STRING
          value: Sketch002
      group: Base
    MakeInternals:
      kind: Primitive
      paths:
        .:
          type: BOOL
          value: true
      group: Internal Geometry
    MapMode:
      kind: Primitive
      paths:
        .:
          type: STRING
          value: FlatFace
      group: Attachment
    MapReversed:
      kind: Primitive
      paths:
        .:
          type: BOOL
          value: false
      group: Attachment
    Placement:
      kind: Placement
      paths:
        Base.x:
          type: QUANTITY
          value: 0.0 mm
        Base.y:
          type: QUANTITY
          value: 0.0 mm
        Base.z:
          type: QUANTITY
          value: 0.0 mm
        Rotation.Angle:
          type: QUANTITY
          value: 45.00000000000001 deg
        Rotation.Axis.x:
          type: FLOAT
          value: 1.0
        Rotation.Axis.y:
          type: FLOAT
          value: 0.0
        Rotation.Axis.z:
          type: FLOAT
          value: 0.0
      group: Base
- name: Pocket001
  id: 1647
  type_id: PartDesign::Pocket
  properties:
    AllowMultiFace:
      kind: Primitive
      paths:
        .:
          type: BOOL
          value: true
      group: SketchBased
    AlongSketchNormal:
      kind: Primitive
      paths:
        .:
          type: BOOL
          value: true
      group: Pocket
    FuzzyTolerance:
      kind: Primitive
      paths:
        .:
          type: FLOAT
          value: 0.0
      group: Part Design
    Label:
      kind: Primitive
      paths:
        .:
          type: STRING
          value: Pocket001
      group: Base
    Length:
      kind: Primitive
      paths:
        .:
          type: QUANTITY
          value: 20.0 mm
      group: Side1
    Length2:
      kind: Primitive
      paths:
        .:
          type: QUANTITY
          value: 5.0 mm
      group: Side2
    Midplane:
      kind: Primitive
      paths:
        .:
          type: BOOL
          value: false
      group: SketchBased
    Offset:
      kind: Primitive
      paths:
        .:
          type: QUANTITY
          value: 0.0 mm
      group: Side1
    Offset2:
      kind: Primitive
      paths:
        .:
          type: QUANTITY
          value: 0.0 mm
      group: Side2
    Profile:
      kind: List
      paths: {}
      items:
      - kind: Unknown
        paths:
          .:
            type: STRING
            value: <Sketcher::SketchObject>
            freecad_type: Sketcher.SketchObject
      - kind: List
        paths: {}
        items:
        - kind: Primitive
          paths:
            .:
              type: STRING
              value: ''
      group: SketchBased
    ReferenceAxis:
      kind: List
      paths: {}
      items:
      - kind: Unknown
        paths:
          .:
            type: STRING
            value: <Sketcher::SketchObject>
            freecad_type: Sketcher.SketchObject
      - kind: List
        paths: {}
        items:
        - kind: Primitive
          paths:
            .:
              type: STRING
              value: N_Axis
      group: Pocket
    Refine:
      kind: Primitive
      paths:
        .:
          type: BOOL
          value: true
      group: Part Design
    Reversed:
      kind: Primitive
      paths:
        .:
          type: BOOL
          value: false
      group: SketchBased
    SideType:
      kind: Primitive
      paths:
        .:
          type: STRING
          value: Symmetric
      group: Pocket
    StartOffset:
      kind: Primitive
      paths:
        .:
          type: QUANTITY
          value: 0.0 mm
      group: Start
    StartReference:
      kind: Primitive
      paths:
        .:
          type: 'NULL'
      group: Start
    StartType:
      kind: Primitive
      paths:
        .:
          type: STRING
          value: Profile plane
      group: Start
    Suppressed:
      kind: Primitive
      paths:
        .:
          type: BOOL
          value: false
      group: Base
    TaperAngle:
      kind: Primitive
      paths:
        .:
          type: QUANTITY
          value: 0.0 deg
      group: Side1
    TaperAngle2:
      kind: Primitive
      paths:
        .:
          type: QUANTITY
          value: 0.0 deg
      group: Side2
    Type:
      kind: Primitive
      paths:
        .:
          type: STRING
          value: Length
      group: Side1
    Type2:
      kind: Primitive
      paths:
        .:
          type: STRING
          value: Length
      group: Side2
    UpToFace:
      kind: Primitive
      paths:
        .:
          type: 'NULL'
      group: Side1
    UpToFace2:
      kind: Primitive
      paths:
        .:
          type: 'NULL'
      group: Side2
    UseCustomVector:
      kind: Primitive
      paths:
        .:
          type: BOOL
          value: false
      group: Pocket
- name: Chamfer
  id: 1648
  type_id: PartDesign::Chamfer
  properties:
    Angle:
      kind: Primitive
      paths:
        .:
          type: QUANTITY
          value: 45.0 deg
      group: Chamfer
    Base:
      kind: List
      paths: {}
      items:
      - kind: Unknown
        paths:
          .:
            type: STRING
            value: <PartDesign::Pocket>
            freecad_type: PartDesign.Feature
      - kind: List
        paths: {}
        items:
        - kind: Primitive
          paths:
            .:
              type: STRING
              value: Edge6
        - kind: Primitive
          paths:
            .:
              type: STRING
              value: Edge16
        - kind: Primitive
          paths:
            .:
              type: STRING
              value: Edge3
        - kind: Primitive
          paths:
            .:
              type: STRING
              value: Edge2
        - kind: Primitive
          paths:
            .:
              type: STRING
              value: Edge9
        - kind: Primitive
          paths:
            .:
              type: STRING
              value: Edge7
        - kind: Primitive
          paths:
            .:
              type: STRING
              value: Edge10
        - kind: Primitive
          paths:
            .:
              type: STRING
              value: Edge8
        - kind: Primitive
          paths:
            .:
              type: STRING
              value: Edge20
        - kind: Primitive
          paths:
            .:
              type: STRING
              value: Edge24
        - kind: Primitive
          paths:
            .:
              type: STRING
              value: Edge22
        - kind: Primitive
          paths:
            .:
              type: STRING
              value: Edge18
        - kind: Primitive
          paths:
            .:
              type: STRING
              value: Edge27
        - kind: Primitive
          paths:
            .:
              type: STRING
              value: Edge11
      group: Base
    ChamferType:
      kind: Primitive
      paths:
        .:
          type: STRING
          value: Equal distance
      group: Chamfer
    FlipDirection:
      kind: Primitive
      paths:
        .:
          type: BOOL
          value: false
      group: Chamfer
    FuzzyTolerance:
      kind: Primitive
      paths:
        .:
          type: FLOAT
          value: 0.0
      group: Part Design
    Label:
      kind: Primitive
      paths:
        .:
          type: STRING
          value: Chamfer
      group: Base
    Refine:
      kind: Primitive
      paths:
        .:
          type: BOOL
          value: true
      group: Part Design
    Size:
      kind: Primitive
      paths:
        .:
          type: QUANTITY
          value: 0.2 mm
      group: Chamfer
    Size2:
      kind: Primitive
      paths:
        .:
          type: QUANTITY
          value: 1.0 mm
      group: Chamfer
    SupportTransform:
      kind: Primitive
      paths:
        .:
          type: BOOL
          value: false
      group: Base
    Suppressed:
      kind: Primitive
      paths:
        .:
          type: BOOL
          value: false
      group: Base
    UseAllEdges:
      kind: Primitive
      paths:
        .:
          type: BOOL
          value: false
      group: Chamfer
occurrences:
- path: Body
  after: null
- path: Body/Chamfer
  after: Body/Pocket001
- path: Body/Origin
  after: null
- path: Body/Origin/Origin001
  after: Body/Origin/YZ_Plane
- path: Body/Origin/XY_Plane
  after: Body/Origin/Z_Axis
- path: Body/Origin/XZ_Plane
  after: Body/Origin/XY_Plane
- path: Body/Origin/X_Axis
  after: null
- path: Body/Origin/YZ_Plane
  after: Body/Origin/XZ_Plane
- path: Body/Origin/Y_Axis
  after: Body/Origin/X_Axis
- path: Body/Origin/Z_Axis
  after: Body/Origin/Y_Axis
- path: Body/Pocket
  after: Body/Revolution
- path: Body/Pocket/Sketch001
  after: null
- path: Body/Pocket001
  after: Body/PolarPattern
- path: Body/Pocket001/Sketch002
  after: null
- path: Body/PolarPattern
  after: Body/Pocket
- path: Body/Revolution
  after: Body/Origin
- path: Body/Revolution/Sketch
  after: null
