Barbatronic/Omni-RC-Robot/mcad/.snapshots/omni-wheel.yaml

v: 2
timestamp: '2026-08-29T11:19:20.040773'
uid: 079c154c-ae16-4f54-8fc6-bfcc7b306ea5
objects:
- name: Body047
  id: 4119
  type_id: PartDesign::Body
  properties:
    AllowCompound:
      kind: Primitive
      paths:
        .:
          type: BOOL
          value: true
      group: Base
    BaseFeature:
      kind: Primitive
      paths:
        .:
          type: 'NULL'
      group: Base
    Label:
      kind: Primitive
      paths:
        .:
          type: STRING
          value: MainPlate
      group: Base
    Placement:
      kind: Placement
      paths:
        Base.x:
          type: QUANTITY
          value: 0.0 mm
        Base.y:
          type: QUANTITY
          value: 0.0 mm
        Base.z:
          type: QUANTITY
          value: 0.0 mm
        Rotation.Angle:
          type: QUANTITY
          value: 0.0 deg
        Rotation.Axis.x:
          type: FLOAT
          value: 0.0
        Rotation.Axis.y:
          type: FLOAT
          value: 0.0
        Rotation.Axis.z:
          type: FLOAT
          value: 1.0
      group: Base
    Tip:
      kind: Unknown
      paths:
        .:
          type: STRING
          value: <PartDesign::PolarPattern>
          freecad_type: PartDesign.Feature
      group: Base
- name: Body050
  id: 4120
  type_id: PartDesign::Body
  properties:
    AllowCompound:
      kind: Primitive
      paths:
        .:
          type: BOOL
          value: true
      group: Base
    BaseFeature:
      kind: Primitive
      paths:
        .:
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
        Rotation.Angle:
          type: QUANTITY
          value: 180.0 deg
        Rotation.Axis.x:
          type: FLOAT
          value: 0.0
        Rotation.Axis.y:
          type: FLOAT
          value: 0.7071067811865476
        Rotation.Axis.z:
          type: FLOAT
          value: 0.7071067811865475
      group: Base
    ResizeMode:
      kind: Primitive
      paths:
        .:
          type: STRING
          value: Automatic
      group: Size
- name: Fillet029
  id: 4124
  type_id: PartDesign::Fillet
  properties:
    Base:
      kind: List
      paths: {}
      items:
      - kind: Unknown
        paths:
          .:
            type: STRING
            value: <PartDesign::Revolution>
            freecad_type: PartDesign.Feature
      - kind: List
        paths: {}
        items:
        - kind: Primitive
          paths:
            .:
              type: STRING
              value: Edge3
        - kind: Primitive
          paths:
            .:
              type: STRING
              value: Edge1
      group: Base
    FuzzyTolerance:
      kind: Primitive
      paths:
        .:
          type: FLOAT
          value: 0.0
      group: Part Design
    Label:
      kind: Primitive
      paths:
        .:
          type: STRING
          value: Fillet029
      group: Base
    Radius:
      kind: Primitive
      paths:
        .:
          type: QUANTITY
          value: 0.2 mm
      group: Fillet
    Refine:
      kind: Primitive
      paths:
        .:
          type: BOOL
          value: true
      group: Part Design
    SupportTransform:
      kind: Primitive
      paths:
        .:
          type: BOOL
          value: false
      group: Base
    Suppressed:
      kind: Primitive
      paths:
        .:
          type: BOOL
          value: false
      group: Base
    UseAllEdges:
      kind: Primitive
      paths:
        .:
          type: BOOL
          value: false
      group: Fillet
- name: Link084
  id: 4126
  type_id: App::Link
  properties:
    ElementCount:
      kind: Primitive
      paths:
        .:
          type: INT
          value: 0
      group: ' Link'
    Label:
      kind: Primitive
      paths:
        .:
          type: STRING
          value: Roller001
      group: Base
    LinkClaimChild:
      kind: Primitive
      paths:
        .:
          type: BOOL
          value: false
      group: ' Link'
    LinkCopyOnChange:
      kind: Primitive
      paths:
        .:
          type: STRING
          value: Disabled
      group: ' Link'
    LinkExecute:
      kind: Primitive
      paths:
        .:
          type: STRING
          value: ''
      group: ' Link'
    LinkTransform:
      kind: Primitive
      paths:
        .:
          type: BOOL
          value: false
      group: ' Link'
    Placement:
      kind: Placement
      paths:
        Base.x:
          type: QUANTITY
          value: 0.0 mm
        Base.y:
          type: QUANTITY
          value: 0.0 mm
        Base.z:
          type: QUANTITY
          value: 0.0 mm
        Rotation.Angle:
          type: QUANTITY
          value: 72.00000420303864 deg
        Rotation.Axis.x:
          type: FLOAT
          value: 0.0
        Rotation.Axis.y:
          type: FLOAT
          value: -1.0
        Rotation.Axis.z:
          type: FLOAT
          value: 0.0
      group: ' Link'
    Scale:
      kind: Primitive
      paths:
        .:
          type: FLOAT
          value: 1.0
      group: ' Link'
    ShowElement:
      kind: Primitive
      paths:
        .:
          type: BOOL
          value: true
      group: ' Link'
- name: Link085
  id: 4127
  type_id: App::Link
  properties:
    ElementCount:
      kind: Primitive
      paths:
        .:
          type: INT
          value: 0
      group: ' Link'
    Label:
      kind: Primitive
      paths:
        .:
          type: STRING
          value: Roller002
      group: Base
    LinkClaimChild:
      kind: Primitive
      paths:
        .:
          type: BOOL
          value: false
      group: ' Link'
    LinkCopyOnChange:
      kind: Primitive
      paths:
        .:
          type: STRING
          value: Disabled
      group: ' Link'
    LinkExecute:
      kind: Primitive
      paths:
        .:
          type: STRING
          value: ''
      group: ' Link'
    LinkTransform:
      kind: Primitive
      paths:
        .:
          type: BOOL
          value: false
      group: ' Link'
    Placement:
      kind: Placement
      paths:
        Base.x:
          type: QUANTITY
          value: 0.0 mm
        Base.y:
          type: QUANTITY
          value: 0.0 mm
        Base.z:
          type: QUANTITY
          value: 0.0 mm
        Rotation.Angle:
          type: QUANTITY
          value: 215.99999680669785 deg
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
      paths:
        .:
          type: STRING
          value: Pad057
      group: Base
    Length:
      kind: Primitive
      paths:
        .:
          type: QUANTITY
          value: 5.5 mm
      group: Side1
    Length2:
      kind: Primitive
      paths:
        .:
          type: QUANTITY
          value: 100.0 mm
      group: Side2
    Midplane:
      kind: Primitive
      paths:
        .:
          type: BOOL
          value: false
      group: SketchBased
    Offset:
      kind: Primitive
      paths:
        .:
          type: QUANTITY
          value: 0.0 mm
      group: Side1
    Offset2:
      kind: Primitive
      paths:
        .:
          type: QUANTITY
          value: 0.0 mm
      group: Side2
    Profile:
      kind: List
      paths: {}
      items:
      - kind: Unknown
        paths:
          .:
            type: STRING
            value: <Sketcher::SketchObject>
            freecad_type: Sketcher.SketchObject
      - kind: List
        paths: {}
        items: []
      group: SketchBased
    ReferenceAxis:
      kind: Primitive
      paths:
        .:
          type: 'NULL'
      group: Pad
    Refine:
      kind: Primitive
      paths:
        .:
          type: BOOL
          value: true
      group: Part Design
    Reversed:
      kind: Primitive
      paths:
        .:
          type: BOOL
          value: false
      group: SketchBased
    SideType:
      kind: Primitive
      paths:
        .:
          type: STRING
          value: Symmetric
      group: Pad
    StartOffset:
      kind: Primitive
      paths:
        .:
          type: QUANTITY
          value: 0.0 mm
      group: Start
    StartReference:
      kind: Primitive
      paths:
        .:
          type: 'NULL'
      group: Start
    StartType:
      kind: Primitive
      paths:
        .:
          type: STRING
          value: Profile plane
      group: Start
    Suppressed:
      kind: Primitive
      paths:
        .:
          type: BOOL
          value: false
      group: Base
    TaperAngle:
      kind: Primitive
      paths:
        .:
          type: QUANTITY
          value: 0.0 deg
      group: Side1
    TaperAngle2:
      kind: Primitive
      paths:
        .:
          type: QUANTITY
          value: 0.0 deg
      group: Side2
    Type:
      kind: Primitive
      paths:
        .:
          type: STRING
          value: Length
      group: Side1
    Type2:
      kind: Primitive
      paths:
        .:
          type: STRING
          value: Length
      group: Side2
    UpToFace:
      kind: Primitive
      paths:
        .:
          type: 'NULL'
      group: Side1
    UpToFace2:
      kind: Primitive
      paths:
        .:
          type: 'NULL'
      group: Side2
    UseCustomVector:
      kind: Primitive
      paths:
        .:
          type: BOOL
          value: false
      group: Pad
- name: Pad058
  id: 4147
  type_id: PartDesign::Pad
  properties:
    AllowMultiFace:
      kind: Primitive
      paths:
        .:
          type: BOOL
          value: true
      group: SketchBased
    AlongSketchNormal:
      kind: Primitive
      paths:
        .:
          type: BOOL
          value: true
      group: Pad
    FuzzyTolerance:
      kind: Primitive
      paths:
        .:
          type: FLOAT
          value: 0.0
      group: Part Design
    Label:
      kind: Primitive
      paths:
        .:
          type: STRING
          value: Pad058
      group: Base
    Length:
      kind: Primitive
      paths:
        .:
          type: QUANTITY
          value: 2.5 mm
      group: Side1
    Length2:
      kind: Primitive
      paths:
        .:
          type: QUANTITY
          value: 100.0 mm
      group: Side2
    Midplane:
      kind: Primitive
      paths:
        .:
          type: BOOL
          value: false
      group: SketchBased
    Offset:
      kind: Primitive
      paths:
        .:
          type: QUANTITY
          value: 0.0 mm
      group: Side1
    Offset2:
      kind: Primitive
      paths:
        .:
          type: QUANTITY
          value: 0.0 mm
      group: Side2
    Profile:
      kind: List
      paths: {}
      items:
      - kind: Unknown
        paths:
          .:
            type: STRING
            value: <Sketcher::SketchObject>
            freecad_type: Sketcher.SketchObject
      - kind: List
        paths: {}
        items: []
      group: SketchBased
    ReferenceAxis:
      kind: Primitive
      paths:
        .:
          type: 'NULL'
      group: Pad
    Refine:
      kind: Primitive
      paths:
        .:
          type: BOOL
          value: true
      group: Part Design
    Reversed:
      kind: Primitive
      paths:
        .:
          type: BOOL
          value: false
      group: SketchBased
    SideType:
      kind: Primitive
      paths:
        .:
          type: STRING
          value: Symmetric
      group: Pad
    StartOffset:
      kind: Primitive
      paths:
        .:
          type: QUANTITY
          value: 0.0 mm
      group: Start
    StartReference:
      kind: Primitive
      paths:
        .:
          type: 'NULL'
      group: Start
    StartType:
      kind: Primitive
      paths:
        .:
          type: STRING
          value: Profile plane
      group: Start
    Suppressed:
      kind: Primitive
      paths:
        .:
          type: BOOL
          value: false
      group: Base
    TaperAngle:
      kind: Primitive
      paths:
        .:
          type: QUANTITY
          value: 0.0 deg
      group: Side1
    TaperAngle2:
      kind: Primitive
      paths:
        .:
          type: QUANTITY
          value: 0.0 deg
      group: Side2
    Type:
      kind: Primitive
      paths:
        .:
          type: STRING
          value: Length
      group: Side1
    Type2:
      kind: Primitive
      paths:
        .:
          type: STRING
          value: Length
      group: Side2
    UpToFace:
      kind: Primitive
      paths:
        .:
          type: 'NULL'
      group: Side1
    UpToFace2:
      kind: Primitive
      paths:
        .:
          type: 'NULL'
      group: Side2
    UseCustomVector:
      kind: Primitive
      paths:
        .:
          type: BOOL
          value: false
      group: Pad
- name: Pad059
  id: 4148
  type_id: PartDesign::Pad
  properties:
    AllowMultiFace:
      kind: Primitive
      paths:
        .:
          type: BOOL
          value: true
      group: SketchBased
    AlongSketchNormal:
      kind: Primitive
      paths:
        .:
          type: BOOL
          value: true
      group: Pad
    FuzzyTolerance:
      kind: Primitive
      paths:
        .:
          type: FLOAT
          value: 0.0
      group: Part Design
    Label:
      kind: Primitive
      paths:
        .:
          type: STRING
          value: Pad059
      group: Base
    Length:
      kind: Primitive
      paths:
        .:
          type: QUANTITY
          value: 20.0 mm
      group: Side1
    Length2:
      kind: Primitive
      paths:
        .:
          type: QUANTITY
          value: 100.0 mm
      group: Side2
    Midplane:
      kind: Primitive
      paths:
        .:
          type: BOOL
          value: false
      group: SketchBased
    Offset:
      kind: Primitive
      paths:
        .:
          type: QUANTITY
          value: 0.0 mm
      group: Side1
    Offset2:
      kind: Primitive
      paths:
        .:
          type: QUANTITY
          value: 0.0 mm
      group: Side2
    Profile:
      kind: List
      paths: {}
      items:
      - kind: Unknown
        paths:
          .:
            type: STRING
            value: <Sketcher::SketchObject>
            freecad_type: Sketcher.SketchObject
      - kind: List
        paths: {}
        items: []
      group: SketchBased
    ReferenceAxis:
      kind: Primitive
      paths:
        .:
          type: 'NULL'
      group: Pad
    Refine:
      kind: Primitive
      paths:
        .:
          type: BOOL
          value: true
      group: Part Design
    Reversed:
      kind: Primitive
      paths:
        .:
          type: BOOL
          value: false
      group: SketchBased
    SideType:
      kind: Primitive
      paths:
        .:
          type: STRING
          value: Symmetric
      group: Pad
    StartOffset:
      kind: Primitive
      paths:
        .:
          type: QUANTITY
          value: 0.0 mm
      group: Start
    StartReference:
      kind: Primitive
      paths:
        .:
          type: 'NULL'
      group: Start
    StartType:
      kind: Primitive
      paths:
        .:
          type: STRING
          value: Profile plane
      group: Start
    Suppressed:
      kind: Primitive
      paths:
        .:
          type: BOOL
          value: false
      group: Base
    TaperAngle:
      kind: Primitive
      paths:
        .:
          type: QUANTITY
          value: 0.0 deg
      group: Side1
    TaperAngle2:
      kind: Primitive
      paths:
        .:
          type: QUANTITY
          value: 0.0 deg
      group: Side2
    Type:
      kind: Primitive
      paths:
        .:
          type: STRING
          value: Length
      group: Side1
    Type2:
      kind: Primitive
      paths:
        .:
          type: STRING
          value: Length
      group: Side2
    UpToFace:
      kind: Primitive
      paths:
        .:
          type: 'NULL'
      group: Side1
    UpToFace2:
      kind: Primitive
      paths:
        .:
          type: 'NULL'
      group: Side2
    UseCustomVector:
      kind: Primitive
      paths:
        .:
          type: BOOL
          value: false
      group: Pad
- name: Part018
  id: 4149
  type_id: App::Part
  properties:
    Color:
      kind: List
      paths: {}
      items:
      - kind: Primitive
        paths:
          .:
            type: FLOAT
            value: 1.0
      - kind: Primitive
        paths:
          .:
            type: FLOAT
            value: 1.0
      - kind: Primitive
        paths:
          .:
            type: FLOAT
            value: 1.0
      - kind: Primitive
        paths:
          .:
            type: FLOAT
            value: 0.0
      group: Base
    Id:
      kind: Primitive
      paths:
        .:
          type: STRING
          value: ''
      group: Base
    Label:
      kind: Primitive
      paths:
        .:
          type: STRING
          value: OmniPancake
      group: Base
    License:
      kind: Primitive
      paths:
        .:
          type: STRING
          value: ''
      group: Base
    LicenseURL:
      kind: Primitive
      paths:
        .:
          type: STRING
          value: ''
      group: Base
    Material:
      kind: Primitive
      paths:
        .:
          type: 'NULL'
      group: Base
    Placement:
      kind: Placement
      paths:
        Base.x:
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
          value: 0.0
        Rotation.Axis.z:
          type: FLOAT
          value: 1.0
      group: Base
    Type:
      kind: Primitive
      paths:
        .:
          type: STRING
          value: ''
      group: Base
    Uid:
      kind: Primitive
      paths:
        .:
          type: STRING
          value: dbe1efe5-dbca-4201-a08b-a85830dd4e08
      group: Base
- name: Pocket036
  id: 4152
  type_id: PartDesign::Pocket
  properties:
    AllowMultiFace:
      kind: Primitive
      paths:
        .:
          type: BOOL
          value: true
      group: SketchBased
    AlongSketchNormal:
      kind: Primitive
      paths:
        .:
          type: BOOL
          value: true
      group: Pocket
    FuzzyTolerance:
      kind: Primitive
      paths:
        .:
          type: FLOAT
          value: 0.0
      group: Part Design
    Label:
      kind: Primitive
      paths:
        .:
          type: STRING
          value: Pocket036
      group: Base
    Length:
      kind: Primitive
      paths:
        .:
          type: QUANTITY
          value: 5.0 mm
      group: Side1
    Length2:
      kind: Primitive
      paths:
        .:
          type: QUANTITY
          value: 100.0 mm
      group: Side2
    Midplane:
      kind: Primitive
      paths:
        .:
          type: BOOL
          value: false
      group: SketchBased
    Offset:
      kind: Primitive
      paths:
        .:
          type: QUANTITY
          value: 0.0 mm
      group: Side1
    Offset2:
      kind: Primitive
      paths:
        .:
          type: QUANTITY
          value: 0.0 mm
      group: Side2
    Profile:
      kind: List
      paths: {}
      items:
      - kind: Unknown
        paths:
          .:
            type: STRING
            value: <Sketcher::SketchObject>
            freecad_type: Sketcher.SketchObject
      - kind: List
        paths: {}
        items: []
      group: SketchBased
    ReferenceAxis:
      kind: Primitive
      paths:
        .:
          type: 'NULL'
      group: Pocket
    Refine:
      kind: Primitive
      paths:
        .:
          type: BOOL
          value: true
      group: Part Design
    Reversed:
      kind: Primitive
      paths:
        .:
          type: BOOL
          value: false
      group: SketchBased
    SideType:
      kind: Primitive
      paths:
        .:
          type: STRING
          value: Symmetric
      group: Pocket
    StartOffset:
      kind: Primitive
      paths:
        .:
          type: QUANTITY
          value: 0.0 mm
      group: Start
    StartReference:
      kind: Primitive
      paths:
        .:
          type: 'NULL'
      group: Start
    StartType:
      kind: Primitive
      paths:
        .:
          type: STRING
          value: Profile plane
      group: Start
    Suppressed:
      kind: Primitive
      paths:
        .:
          type: BOOL
          value: false
      group: Base
    TaperAngle:
      kind: Primitive
      paths:
        .:
          type: QUANTITY
          value: 0.0 deg
      group: Side1
    TaperAngle2:
      kind: Primitive
      paths:
        .:
          type: QUANTITY
          value: 0.0 deg
      group: Side2
    Type:
      kind: Primitive
      paths:
        .:
          type: STRING
          value: ThroughAll
      group: Side1
    Type2:
      kind: Primitive
      paths:
        .:
          type: STRING
          value: Length
      group: Side2
    UpToFace:
      kind: Primitive
      paths:
        .:
          type: 'NULL'
      group: Side1
    UpToFace2:
      kind: Primitive
      paths:
        .:
          type: 'NULL'
      group: Side2
    UseCustomVector:
      kind: Primitive
      paths:
        .:
          type: BOOL
          value: false
      group: Pocket
- name: Pocket037
  id: 4153
  type_id: PartDesign::Pocket
  properties:
    AllowMultiFace:
      kind: Primitive
      paths:
        .:
          type: BOOL
          value: true
      group: SketchBased
    AlongSketchNormal:
      kind: Primitive
      paths:
        .:
          type: BOOL
          value: true
      group: Pocket
    FuzzyTolerance:
      kind: Primitive
      paths:
        .:
          type: FLOAT
          value: 0.0
      group: Part Design
    Label:
      kind: Primitive
      paths:
        .:
          type: STRING
          value: Pocket037
      group: Base
    Length:
      kind: Primitive
      paths:
        .:
          type: QUANTITY
          value: 5.0 mm
      group: Side1
    Length2:
      kind: Primitive
      paths:
        .:
          type: QUANTITY
          value: 100.0 mm
      group: Side2
    Midplane:
      kind: Primitive
      paths:
        .:
          type: BOOL
          value: false
      group: SketchBased
    Offset:
      kind: Primitive
      paths:
        .:
          type: QUANTITY
          value: 0.0 mm
      group: Side1
    Offset2:
      kind: Primitive
      paths:
        .:
          type: QUANTITY
          value: 0.0 mm
      group: Side2
    Profile:
      kind: List
      paths: {}
      items:
      - kind: Unknown
        paths:
          .:
            type: STRING
            value: <Sketcher::SketchObject>
            freecad_type: Sketcher.SketchObject
      - kind: List
        paths: {}
        items: []
      group: SketchBased
    ReferenceAxis:
      kind: Primitive
      paths:
        .:
          type: 'NULL'
      group: Pocket
    Refine:
      kind: Primitive
      paths:
        .:
          type: BOOL
          value: true
      group: Part Design
    Reversed:
      kind: Primitive
      paths:
        .:
          type: BOOL
          value: false
      group: SketchBased
    SideType:
      kind: Primitive
      paths:
        .:
          type: STRING
          value: Symmetric
      group: Pocket
    StartOffset:
      kind: Primitive
      paths:
        .:
          type: QUANTITY
          value: 0.0 mm
      group: Start
    StartReference:
      kind: Primitive
      paths:
        .:
          type: 'NULL'
      group: Start
    StartType:
      kind: Primitive
      paths:
        .:
          type: STRING
          value: Profile plane
      group: Start
    Suppressed:
      kind: Primitive
      paths:
        .:
          type: BOOL
          value: false
      group: Base
    TaperAngle:
      kind: Primitive
      paths:
        .:
          type: QUANTITY
          value: 0.0 deg
      group: Side1
    TaperAngle2:
      kind: Primitive
      paths:
        .:
          type: QUANTITY
          value: 0.0 deg
      group: Side2
    Type:
      kind: Primitive
      paths:
        .:
          type: STRING
          value: ThroughAll
      group: Side1
    Type2:
      kind: Primitive
      paths:
        .:
          type: STRING
          value: Length
      group: Side2
    UpToFace:
      kind: Primitive
      paths:
        .:
          type: 'NULL'
      group: Side1
    UpToFace2:
      kind: Primitive
      paths:
        .:
          type: 'NULL'
      group: Side2
    UseCustomVector:
      kind: Primitive
      paths:
        .:
          type: BOOL
          value: false
      group: Pocket
- name: Pocket038
  id: 4154
  type_id: PartDesign::Pocket
  properties:
    AllowMultiFace:
      kind: Primitive
      paths:
        .:
          type: BOOL
          value: true
      group: SketchBased
    AlongSketchNormal:
      kind: Primitive
      paths:
        .:
          type: BOOL
          value: true
      group: Pocket
    FuzzyTolerance:
      kind: Primitive
      paths:
        .:
          type: FLOAT
          value: 0.0
      group: Part Design
    Label:
      kind: Primitive
      paths:
        .:
          type: STRING
          value: Pocket038
      group: Base
    Length:
      kind: Primitive
      paths:
        .:
          type: QUANTITY
          value: 5.0 mm
      group: Side1
    Length2:
      kind: Primitive
      paths:
        .:
          type: QUANTITY
          value: 100.0 mm
      group: Side2
    Midplane:
      kind: Primitive
      paths:
        .:
          type: BOOL
          value: false
      group: SketchBased
    Offset:
      kind: Primitive
      paths:
        .:
          type: QUANTITY
          value: 0.0 mm
      group: Side1
    Offset2:
      kind: Primitive
      paths:
        .:
          type: QUANTITY
          value: 0.0 mm
      group: Side2
    Profile:
      kind: List
      paths: {}
      items:
      - kind: Unknown
        paths:
          .:
            type: STRING
            value: <Sketcher::SketchObject>
            freecad_type: Sketcher.SketchObject
      - kind: List
        paths: {}
        items: []
      group: SketchBased
    ReferenceAxis:
      kind: Primitive
      paths:
        .:
          type: 'NULL'
      group: Pocket
    Refine:
      kind: Primitive
      paths:
        .:
          type: BOOL
          value: true
      group: Part Design
    Reversed:
      kind: Primitive
      paths:
        .:
          type: BOOL
          value: false
      group: SketchBased
    SideType:
      kind: Primitive
      paths:
        .:
          type: STRING
          value: Symmetric
      group: Pocket
    StartOffset:
      kind: Primitive
      paths:
        .:
          type: QUANTITY
          value: 0.0 mm
      group: Start
    StartReference:
      kind: Primitive
      paths:
        .:
          type: 'NULL'
      group: Start
    StartType:
      kind: Primitive
      paths:
        .:
          type: STRING
          value: Profile plane
      group: Start
    Suppressed:
      kind: Primitive
      paths:
        .:
          type: BOOL
          value: false
      group: Base
    TaperAngle:
      kind: Primitive
      paths:
        .:
          type: QUANTITY
          value: 0.0 deg
      group: Side1
    TaperAngle2:
      kind: Primitive
      paths:
        .:
          type: QUANTITY
          value: 0.0 deg
      group: Side2
    Type:
      kind: Primitive
      paths:
        .:
          type: STRING
          value: ThroughAll
      group: Side1
    Type2:
      kind: Primitive
      paths:
        .:
          type: STRING
          value: Length
      group: Side2
    UpToFace:
      kind: Primitive
      paths:
        .:
          type: 'NULL'
      group: Side1
    UpToFace2:
      kind: Primitive
      paths:
        .:
          type: 'NULL'
      group: Side2
    UseCustomVector:
      kind: Primitive
      paths:
        .:
          type: BOOL
          value: false
      group: Pocket
- name: PolarPattern017
  id: 4155
  type_id: PartDesign::PolarPattern
  properties:
    Angle:
      kind: Primitive
      paths:
        .:
          type: QUANTITY
          value: 360.0 deg
      group: PolarPattern
    Axis:
      kind: List
      paths: {}
      items:
      - kind: Unknown
        paths:
          .:
            type: STRING
            value: <Sketcher::SketchObject>
            freecad_type: Sketcher.SketchObject
      - kind: List
        paths: {}
        items:
        - kind: Primitive
          paths:
            .:
              type: STRING
              value: N_Axis
      group: PolarPattern
    FuzzyTolerance:
      kind: Primitive
      paths:
        .:
          type: FLOAT
          value: 0.0
      group: Part Design
    Label:
      kind: Primitive
      paths:
        .:
          type: STRING
          value: PolarPattern017
      group: Base
    Mode:
      kind: Primitive
      paths:
        .:
          type: STRING
          value: Extent
      group: PolarPattern
    Occurrences:
      kind: Primitive
      paths:
        .:
          type: INT
          value: 5
      group: PolarPattern
    Offset:
      kind: Primitive
      paths:
        .:
          type: QUANTITY
          value: 120.0 deg
      group: PolarPattern
    Refine:
      kind: Primitive
      paths:
        .:
          type: BOOL
          value: true
      group: Part Design
    Reversed:
      kind: Primitive
      paths:
        .:
          type: BOOL
          value: false
      group: PolarPattern
    Suppressed:
      kind: Primitive
      paths:
        .:
          type: BOOL
          value: false
      group: Base
    TransformMode:
      kind: Primitive
      paths:
        .:
          type: STRING
          value: Features
      group: Base
- name: PolarPattern018
  id: 4156
  type_id: PartDesign::PolarPattern
  properties:
    Angle:
      kind: Primitive
      paths:
        .:
          type: QUANTITY
          value: 360.0 deg
      group: PolarPattern
    Axis:
      kind: List
      paths: {}
      items:
      - kind: Unknown
        paths:
          .:
            type: STRING
            value: <GeoFeature object>
            freecad_type: App.GeoFeature
      - kind: List
        paths: {}
        items:
        - kind: Primitive
          paths:
            .:
              type: STRING
              value: ''
      group: PolarPattern
    FuzzyTolerance:
      kind: Primitive
      paths:
        .:
          type: FLOAT
          value: 0.0
      group: Part Design
    Label:
      kind: Primitive
      paths:
        .:
          type: STRING
          value: PolarPattern018
      group: Base
    Mode:
      kind: Primitive
      paths:
        .:
          type: STRING
          value: Extent
      group: PolarPattern
    Occurrences:
      kind: Primitive
      paths:
        .:
          type: INT
          value: 5
      group: PolarPattern
    Offset:
      kind: Primitive
      paths:
        .:
          type: QUANTITY
          value: 120.0 deg
      group: PolarPattern
    Refine:
      kind: Primitive
      paths:
        .:
          type: BOOL
          value: true
      group: Part Design
    Reversed:
      kind: Primitive
      paths:
        .:
          type: BOOL
          value: false
      group: PolarPattern
    Suppressed:
      kind: Primitive
      paths:
        .:
          type: BOOL
          value: false
      group: Base
    TransformMode:
      kind: Primitive
      paths:
        .:
          type: STRING
          value: Features
      group: Base
- name: PolarPattern019
  id: 4157
  type_id: PartDesign::PolarPattern
  properties:
    Angle:
      kind: Primitive
      paths:
        .:
          type: QUANTITY
          value: 360.0 deg
      group: PolarPattern
    Axis:
      kind: List
      paths: {}
      items:
      - kind: Unknown
        paths:
          .:
            type: STRING
            value: <GeoFeature object>
            freecad_type: App.GeoFeature
      - kind: List
        paths: {}
        items:
        - kind: Primitive
          paths:
            .:
              type: STRING
              value: ''
      group: PolarPattern
    FuzzyTolerance:
      kind: Primitive
      paths:
        .:
          type: FLOAT
          value: 0.0
      group: Part Design
    Label:
      kind: Primitive
      paths:
        .:
          type: STRING
          value: PolarPattern019
      group: Base
    Mode:
      kind: Primitive
      paths:
        .:
          type: STRING
          value: Extent
      group: PolarPattern
    Occurrences:
      kind: Primitive
      paths:
        .:
          type: INT
          value: 6
      group: PolarPattern
    Offset:
      kind: Primitive
      paths:
        .:
          type: QUANTITY
          value: 120.0 deg
      group: PolarPattern
    Refine:
      kind: Primitive
      paths:
        .:
          type: BOOL
          value: true
      group: Part Design
    Reversed:
      kind: Primitive
      paths:
        .:
          type: BOOL
          value: false
      group: PolarPattern
    Suppressed:
      kind: Primitive
      paths:
        .:
          type: BOOL
          value: false
      group: Base
    TransformMode:
      kind: Primitive
      paths:
        .:
          type: STRING
          value: Features
      group: Base
- name: PolarPattern020
  id: 4158
  type_id: PartDesign::PolarPattern
  properties:
    Angle:
      kind: Primitive
      paths:
        .:
          type: QUANTITY
          value: 360.0 deg
      group: PolarPattern
    Axis:
      kind: List
      paths: {}
      items:
      - kind: Unknown
        paths:
          .:
            type: STRING
            value: <Sketcher::SketchObject>
            freecad_type: Sketcher.SketchObject
      - kind: List
        paths: {}
        items:
        - kind: Primitive
          paths:
            .:
              type: STRING
              value: N_Axis
      group: PolarPattern
    FuzzyTolerance:
      kind: Primitive
      paths:
        .:
          type: FLOAT
          value: 0.0
      group: Part Design
    Label:
      kind: Primitive
      paths:
        .:
          type: STRING
          value: PolarPattern020
      group: Base
    Mode:
      kind: Primitive
      paths:
        .:
          type: STRING
          value: Extent
      group: PolarPattern
    Occurrences:
      kind: Primitive
      paths:
        .:
          type: INT
          value: 5
      group: PolarPattern
    Offset:
      kind: Primitive
      paths:
        .:
          type: QUANTITY
          value: 120.0 deg
      group: PolarPattern
    Refine:
      kind: Primitive
      paths:
        .:
          type: BOOL
          value: true
      group: Part Design
    Reversed:
      kind: Primitive
      paths:
        .:
          type: BOOL
          value: false
      group: PolarPattern
    Suppressed:
      kind: Primitive
      paths:
        .:
          type: BOOL
          value: false
      group: Base
    TransformMode:
      kind: Primitive
      paths:
        .:
          type: STRING
          value: Features
      group: Base
- name: Revolution003
  id: 4159
  type_id: PartDesign::Revolution
  properties:
    AllowMultiFace:
      kind: Primitive
      paths:
        .:
          type: BOOL
          value: true
      group: SketchBased
    Angle:
      kind: Primitive
      paths:
        .:
          type: QUANTITY
          value: 360.0 deg
      group: Side1
    Angle2:
      kind: Primitive
      paths:
        .:
          type: QUANTITY
          value: 0.0 deg
      group: Side2
    FuzzyTolerance:
      kind: Primitive
      paths:
        .:
          type: FLOAT
          value: 0.0
      group: Part Design
    Label:
      kind: Primitive
      paths:
        .:
          type: STRING
          value: Revolution003
      group: Base
    Midplane:
      kind: Primitive
      paths:
        .:
          type: BOOL
          value: false
      group: SketchBased
    Profile:
      kind: List
      paths: {}
      items:
      - kind: Unknown
        paths:
          .:
            type: STRING
            value: <Sketcher::SketchObject>
            freecad_type: Sketcher.SketchObject
      - kind: List
        paths: {}
        items: []
      group: SketchBased
    ReferenceAxis:
      kind: List
      paths: {}
      items:
      - kind: Unknown
        paths:
          .:
            type: STRING
            value: <PartDesign::Line>
            freecad_type: Part.Feature
      - kind: List
        paths: {}
        items:
        - kind: Primitive
          paths:
            .:
              type: STRING
              value: ''
      group: Revolution
    Refine:
      kind: Primitive
      paths:
        .:
          type: BOOL
          value: true
      group: Part Design
    Reversed:
      kind: Primitive
      paths:
        .:
          type: BOOL
          value: false
      group: SketchBased
    SideType:
      kind: Primitive
      paths:
        .:
          type: STRING
          value: One side
      group: Revolution
    Suppressed:
      kind: Primitive
      paths:
        .:
          type: BOOL
          value: false
      group: Base
    Type:
      kind: Primitive
      paths:
        .:
          type: STRING
          value: Angle
      group: Side1
    Type2:
      kind: Primitive
      paths:
        .:
          type: STRING
          value: Angle
      group: Side2
    UpToFace:
      kind: Primitive
      paths:
        .:
          type: 'NULL'
      group: Side1
    UpToFace2:
      kind: Primitive
      paths:
        .:
          type: 'NULL'
      group: Side2
- name: Revolution004
  id: 4160
  type_id: PartDesign::Revolution
  properties:
    AllowMultiFace:
      kind: Primitive
      paths:
        .:
          type: BOOL
          value: true
      group: SketchBased
    Angle:
      kind: Primitive
      paths:
        .:
          type: QUANTITY
          value: 360.0 deg
      group: Side1
    Angle2:
      kind: Primitive
      paths:
        .:
          type: QUANTITY
          value: 0.0 deg
      group: Side2
    FuzzyTolerance:
      kind: Primitive
      paths:
        .:
          type: FLOAT
          value: 0.0
      group: Part Design
    Label:
      kind: Primitive
      paths:
        .:
          type: STRING
          value: Revolution004
      group: Base
    Midplane:
      kind: Primitive
      paths:
        .:
          type: BOOL
          value: false
      group: SketchBased
    Profile:
      kind: List
      paths: {}
      items:
      - kind: Unknown
        paths:
          .:
            type: STRING
            value: <Sketcher::SketchObject>
            freecad_type: Sketcher.SketchObject
      - kind: List
        paths: {}
        items: []
      group: SketchBased
    ReferenceAxis:
      kind: List
      paths: {}
      items:
      - kind: Unknown
        paths:
          .:
            type: STRING
            value: <PartDesign::Line>
            freecad_type: Part.Feature
      - kind: List
        paths: {}
        items:
        - kind: Primitive
          paths:
            .:
              type: STRING
              value: ''
      group: Revolution
    Refine:
      kind: Primitive
      paths:
        .:
          type: BOOL
          value: true
      group: Part Design
    Reversed:
      kind: Primitive
      paths:
        .:
          type: BOOL
          value: true
      group: SketchBased
    SideType:
      kind: Primitive
      paths:
        .:
          type: STRING
          value: One side
      group: Revolution
    Suppressed:
      kind: Primitive
      paths:
        .:
          type: BOOL
          value: false
      group: Base
    Type:
      kind: Primitive
      paths:
        .:
          type: STRING
          value: Angle
      group: Side1
    Type2:
      kind: Primitive
      paths:
        .:
          type: STRING
          value: Angle
      group: Side2
    UpToFace:
      kind: Primitive
      paths:
        .:
          type: 'NULL'
      group: Side1
    UpToFace2:
      kind: Primitive
      paths:
        .:
          type: 'NULL'
      group: Side2
- name: Sketch095
  id: 4161
  type_id: Sketcher::SketchObject
  properties:
    ArcFitTolerance:
      kind: Primitive
      paths:
        .:
          type: FLOAT
          value: 0.0
      group: Sketch
    AttacherEngine:
      kind: Primitive
      paths:
        .:
          type: STRING
          value: Engine Plane
      group: Attachment
    Constraints:
      kind: List
      paths: {}
      items:
      - kind: Constraint
        paths:
          Type:
            type: STRING
            value: Coincident
          Value:
            type: FLOAT
            value: 0.0
          First:
            type: INT
            value: 0
          FirstPos:
            type: INT
            value: 3
          Second:
            type: INT
            value: -1
          SecondPos:
            type: INT
            value: 1
          Third:
            type: INT
            value: -2000
          ThirdPos:
            type: INT
            value: 0
          Driving:
            type: BOOL
            value: true
          IsActive:
            type: BOOL
            value: true
      - kind: Constraint
        paths:
          Type:
            type: STRING
            value: Diameter
          Value:
            type: FLOAT
            value: 28.0
          First:
            type: INT
            value: 0
          FirstPos:
            type: INT
            value: 0
          Second:
            type: INT
            value: -2000
          SecondPos:
            type: INT
            value: 0
          Third:
            type: INT
            value: -2000
          ThirdPos:
            type: INT
            value: 0
          Driving:
            type: BOOL
            value: true
          IsActive:
            type: BOOL
            value: true
      - kind: Constraint
        paths:
          Type:
            type: STRING
            value: Coincident
          Value:
            type: FLOAT
            value: 0.0
          First:
            type: INT
            value: 1
          FirstPos:
            type: INT
            value: 3
          Second:
            type: INT
            value: 0
          SecondPos:
            type: INT
            value: 3
          Third:
            type: INT
            value: -2000
          ThirdPos:
            type: INT
            value: 0
          Driving:
            type: BOOL
            value: true
          IsActive:
            type: BOOL
            value: true
      - kind: Constraint
        paths:
          Type:
            type: STRING
            value: Diameter
          Value:
            type: FLOAT
            value: 57.0
          First:
            type: INT
            value: 1
          FirstPos:
            type: INT
            value: 0
          Second:
            type: INT
            value: -2000
          SecondPos:
            type: INT
            value: 0
          Third:
            type: INT
            value: -2000
          ThirdPos:
            type: INT
            value: 0
          Driving:
            type: BOOL
            value: true
          IsActive:
            type: BOOL
            value: true
      group: Sketch
    Label:
      kind: Primitive
      paths:
        .:
          type: STRING
          value: Sketch095
      group: Base
    MakeInternals:
      kind: Primitive
      paths:
        .:
          type: BOOL
          value: false
      group: Internal Geometry
    MapMode:
      kind: Primitive
      paths:
        .:
          type: STRING
          value: FlatFace
      group: Attachment
    Placement:
      kind: Placement
      paths:
        Base.x:
          type: QUANTITY
          value: 0.0 mm
        Base.y:
          type: QUANTITY
          value: 0.0 mm
        Base.z:
          type: QUANTITY
          value: 0.0 mm
        Rotation.Angle:
          type: QUANTITY
          value: 90.0 deg
        Rotation.Axis.x:
          type: FLOAT
          value: 1.0
        Rotation.Axis.y:
          type: FLOAT
          value: 0.0
        Rotation.Axis.z:
          type: FLOAT
          value: 0.0
      group: Base
- name: Sketch096
  id: 4162
  type_id: Sketcher::SketchObject
  properties:
    ArcFitTolerance:
      kind: Primitive
      paths:
        .:
          type: FLOAT
          value: 0.0
      group: Sketch
    AttacherEngine:
      kind: Primitive
      paths:
        .:
          type: STRING
          value: Engine Plane
      group: Attachment
    Constraints:
      kind: List
      paths: {}
      items:
      - kind: Constraint
        paths:
          Type:
            type: STRING
            value: Coincident
          Value:
            type: FLOAT
            value: 0.0
          First:
            type: INT
            value: 0
          FirstPos:
            type: INT
            value: 3
          Second:
            type: INT
            value: -1
          SecondPos:
            type: INT
            value: 1
          Third:
            type: INT
            value: -2000
          ThirdPos:
            type: INT
            value: 0
          Driving:
            type: BOOL
            value: true
          IsActive:
            type: BOOL
            value: true
      - kind: Constraint
        paths:
          Type:
            type: STRING
            value: Diameter
          Value:
            type: FLOAT
            value: 12.0
          First:
            type: INT
            value: 0
          FirstPos:
            type: INT
            value: 0
          Second:
            type: INT
            value: -2000
          SecondPos:
            type: INT
            value: 0
          Third:
            type: INT
            value: -2000
          ThirdPos:
            type: INT
            value: 0
          Driving:
            type: BOOL
            value: true
          IsActive:
            type: BOOL
            value: true
      - kind: Constraint
        paths:
          Type:
            type: STRING
            value: Coincident
          Value:
            type: FLOAT
            value: 0.0
          First:
            type: INT
            value: 1
          FirstPos:
            type: INT
            value: 3
          Second:
            type: INT
            value: 0
          SecondPos:
            type: INT
            value: 3
          Third:
            type: INT
            value: -2000
          ThirdPos:
            type: INT
            value: 0
          Driving:
            type: BOOL
            value: true
          IsActive:
            type: BOOL
            value: true
      - kind: Constraint
        paths:
          Type:
            type: STRING
            value: Diameter
          Value:
            type: FLOAT
            value: 28.0
          First:
            type: INT
            value: 1
          FirstPos:
            type: INT
            value: 0
          Second:
            type: INT
            value: -2000
          SecondPos:
            type: INT
            value: 0
          Third:
            type: INT
            value: -2000
          ThirdPos:
            type: INT
            value: 0
          Driving:
            type: BOOL
            value: true
          IsActive:
            type: BOOL
            value: true
      group: Sketch
    Label:
      kind: Primitive
      paths:
        .:
          type: STRING
          value: Sketch096
      group: Base
    MakeInternals:
      kind: Primitive
      paths:
        .:
          type: BOOL
          value: false
      group: Internal Geometry
    MapMode:
      kind: Primitive
      paths:
        .:
          type: STRING
          value: FlatFace
      group: Attachment
    Placement:
      kind: Placement
      paths:
        Base.x:
          type: QUANTITY
          value: 0.0 mm
        Base.y:
          type: QUANTITY
          value: 0.0 mm
        Base.z:
          type: QUANTITY
          value: 0.0 mm
        Rotation.Angle:
          type: QUANTITY
          value: 90.00000000000001 deg
        Rotation.Axis.x:
          type: FLOAT
          value: 1.0
        Rotation.Axis.y:
          type: FLOAT
          value: 0.0
        Rotation.Axis.z:
          type: FLOAT
          value: 0.0
      group: Base
- name: Sketch097
  id: 4163
  type_id: Sketcher::SketchObject
  properties:
    ArcFitTolerance:
      kind: Primitive
      paths:
        .:
          type: FLOAT
          value: 0.0
      group: Sketch
    AttacherEngine:
      kind: Primitive
      paths:
        .:
          type: STRING
          value: Engine Plane
      group: Attachment
    Constraints:
      kind: List
      paths: {}
      items:
      - kind: Constraint
        paths:
          Type:
            type: STRING
            value: Vertical
          Value:
            type: FLOAT
            value: 0.0
          First:
            type: INT
            value: 0
          FirstPos:
            type: INT
            value: 0
          Second:
            type: INT
            value: -2000
          SecondPos:
            type: INT
            value: 0
          Third:
            type: INT
            value: -2000
          ThirdPos:
            type: INT
            value: 0
          Driving:
            type: BOOL
            value: true
          IsActive:
            type: BOOL
            value: true
      - kind: Constraint
        paths:
          Type:
            type: STRING
            value: Vertical
          Value:
            type: FLOAT
            value: 0.0
          First:
            type: INT
            value: 1
          FirstPos:
            type: INT
            value: 0
          Second:
            type: INT
            value: -2000
          SecondPos:
            type: INT
            value: 0
          Third:
            type: INT
            value: -2000
          ThirdPos:
            type: INT
            value: 0
          Driving:
            type: BOOL
            value: true
          IsActive:
            type: BOOL
            value: true
      - kind: Constraint
        paths:
          Type:
            type: STRING
            value: Symmetric
          Value:
            type: FLOAT
            value: 0.0
          First:
            type: INT
            value: 1
          FirstPos:
            type: INT
            value: 1
          Second:
            type: INT
            value: 0
          SecondPos:
            type: INT
            value: 1
          Third:
            type: INT
            value: -2
          ThirdPos:
            type: INT
            value: 0
          Driving:
            type: BOOL
            value: true
          IsActive:
            type: BOOL
            value: true
      - kind: Constraint
        paths:
          Type:
            type: STRING
            value: Equal
          Value:
            type: FLOAT
            value: 0.0
          First:
            type: INT
            value: 0
          FirstPos:
            type: INT
            value: 0
          Second:
            type: INT
            value: 1
          SecondPos:
            type: INT
            value: 0
          Third:
            type: INT
            value: -2000
          ThirdPos:
            type: INT
            value: 0
          Driving:
            type: BOOL
            value: true
          IsActive:
            type: BOOL
            value: true
      - kind: Constraint
        paths:
          Type:
            type: STRING
            value: Coincident
          Value:
            type: FLOAT
            value: 0.0
          First:
            type: INT
            value: 2
          FirstPos:
            type: INT
            value: 1
          Second:
            type: INT
            value: 0
          SecondPos:
            type: INT
            value: 2
          Third:
            type: INT
            value: -2000
          ThirdPos:
            type: INT
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
            type: INT
            value: 5
          FirstPos:
            type: INT
            value: 0
          Second:
            type: INT
            value: -2000
          SecondPos:
            type: INT
            value: 0
          Third:
            type: INT
            value: -2000
          ThirdPos:
            type: INT
            value: 0
          Driving:
            type: BOOL
            value: true
          IsActive:
            type: BOOL
            value: true
      group: Sketch
    Label:
      kind: Primitive
      paths:
        .:
          type: STRING
          value: Sketch097
      group: Base
    MakeInternals:
      kind: Primitive
      paths:
        .:
          type: BOOL
          value: false
      group: Internal Geometry
    MapMode:
      kind: Primitive
      paths:
        .:
          type: STRING
          value: FlatFace
      group: Attachment
    Placement:
      kind: Placement
      paths:
        Base.x:
          type: QUANTITY
          value: 0.0 mm
        Base.y:
          type: QUANTITY
          value: 0.0 mm
        Base.z:
          type: QUANTITY
          value: 0.0 mm
        Rotation.Angle:
          type: QUANTITY
          value: 90.0 deg
        Rotation.Axis.x:
          type: FLOAT
          value: 1.0
        Rotation.Axis.y:
          type: FLOAT
          value: 0.0
        Rotation.Axis.z:
          type: FLOAT
          value: 0.0
      group: Base
- name: Sketch098
  id: 4164
  type_id: Sketcher::SketchObject
  properties:
    ArcFitTolerance:
      kind: Primitive
      paths:
        .:
          type: FLOAT
          value: 0.0
      group: Sketch
    AttacherEngine:
      kind: Primitive
      paths:
        .:
          type: STRING
          value: Engine Plane
      group: Attachment
    Constraints:
      kind: List
      paths: {}
      items:
      - kind: Constraint
        paths:
          Type:
            type: STRING
            value: PointOnObject
          Value:
            type: FLOAT
            value: 0.0
          First:
            type: INT
            value: 0
          FirstPos:
            type: INT
            value: 3
          Second:
            type: INT
            value: -2
          SecondPos:
            type: INT
            value: 0
          Third:
            type: INT
            value: -2000
          ThirdPos:
            type: INT
            value: 0
          Driving:
            type: BOOL
            value: true
          IsActive:
            type: BOOL
            value: true
      - kind: Constraint
        paths:
          Type:
            type: STRING
            value: Diameter
          Value:
            type: FLOAT
            value: 2.0
          First:
            type: INT
            value: 0
          FirstPos:
            type: INT
            value: 0
          Second:
            type: INT
            value: -2000
          SecondPos:
            type: INT
            value: 0
          Third:
            type: INT
            value: -2000
          ThirdPos:
            type: INT
            value: 0
          Driving:
            type: BOOL
            value: true
          IsActive:
            type: BOOL
            value: true
      - kind: Constraint
        paths:
          Type:
            type: STRING
            value: Coincident
          Value:
            type: FLOAT
            value: 0.0
          First:
            type: INT
            value: 1
          FirstPos:
            type: INT
            value: 3
          Second:
            type: INT
            value: 0
          SecondPos:
            type: INT
            value: 3
          Third:
            type: INT
            value: -2000
          ThirdPos:
            type: INT
            value: 0
          Driving:
            type: BOOL
            value: true
          IsActive:
            type: BOOL
            value: true
      - kind: Constraint
        paths:
          Type:
            type: STRING
            value: Diameter
          Value:
            type: FLOAT
            value: 13.0
          First:
            type: INT
            value: 1
          FirstPos:
            type: INT
            value: 0
          Second:
            type: INT
            value: -2000
          SecondPos:
            type: INT
            value: 0
          Third:
            type: INT
            value: -2000
          ThirdPos:
            type: INT
            value: 0
          Driving:
            type: BOOL
            value: true
          IsActive:
            type: BOOL
            value: true
      - kind: Constraint
        paths:
          Type:
            type: STRING
            value: PointOnObject
          Value:
            type: FLOAT
            value: 0.0
          First:
            type: INT
            value: 2
          FirstPos:
            type: INT
            value: 1
          Second:
            type: INT
            value: 1
          SecondPos:
            type: INT
            value: 0
          Third:
            type: INT
            value: -2000
          ThirdPos:
            type: INT
            value: 0
          Driving:
            type: BOOL
            value: true
          IsActive:
            type: BOOL
            value: true
      - kind: Constraint
        paths:
          Type:
            type: STRING
            value: PointOnObject
          Value:
            type: FLOAT
            value: 0.0
          First:
            type: INT
            value: 2
          FirstPos:
            type: INT
            value: 1
          Second:
            type: INT
            value: -2
          SecondPos:
            type: INT
            value: 0
          Third:
            type: INT
            value: -2000
          ThirdPos:
            type: INT
            value: 0
          Driving:
            type: BOOL
            value: true
          IsActive:
            type: BOOL
            value: true
      - kind: Constraint
        paths:
          Type:
            type: STRING
            value: DistanceY
          Value:
            type: FLOAT
            value: 30.0
          First:
            type: INT
            value: 2
          FirstPos:
            type: INT
            value: 1
          Second:
            type: INT
            value: -2000
          SecondPos:
            type: INT
            value: 0
          Third:
            type: INT
            value: -2000
          ThirdPos:
            type: INT
            value: 0
          Driving:
            type: BOOL
            value: true
          IsActive:
            type: BOOL
            value: true
      group: Sketch
    Label:
      kind: Primitive
      paths:
        .:
          type: STRING
          value: Sketch098
      group: Base
    MakeInternals:
      kind: Primitive
      paths:
        .:
          type: BOOL
          value: false
      group: Internal Geometry
    MapMode:
      kind: Primitive
      paths:
        .:
          type: STRING
          value: FlatFace
      group: Attachment
    Placement:
      kind: Placement
      paths:
        Base.x:
          type: QUANTITY
          value: 0.0 mm
        Base.y:
          type: QUANTITY
          value: 0.0 mm
        Base.z:
          type: QUANTITY
          value: 0.0 mm
        Rotation.Angle:
          type: QUANTITY
          value: 120.00000000000001 deg
        Rotation.Axis.x:
          type: FLOAT
          value: 0.5773502691896257
        Rotation.Axis.y:
          type: FLOAT
          value: 0.5773502691896257
        Rotation.Axis.z:
          type: FLOAT
          value: 0.5773502691896257
      group: Base
- name: Sketch099
  id: 4165
  type_id: Sketcher::SketchObject
  properties:
    ArcFitTolerance:
      kind: Primitive
      paths:
        .:
          type: FLOAT
          value: 0.0
      group: Sketch
    AttacherEngine:
      kind: Primitive
      paths:
        .:
          type: STRING
          value: Engine Plane
      group: Attachment
    Constraints:
      kind: List
      paths: {}
      items:
      - kind: Constraint
        paths:
          Type:
            type: STRING
            value: PointOnObject
          Value:
            type: FLOAT
            value: 0.0
          First:
            type: INT
            value: 0
          FirstPos:
            type: INT
            value: 3
          Second:
            type: INT
            value: -2
          SecondPos:
            type: INT
            value: 0
          Third:
            type: INT
            value: -2000
          ThirdPos:
            type: INT
            value: 0
          Driving:
            type: BOOL
            value: true
          IsActive:
            type: BOOL
            value: true
      - kind: Constraint
        paths:
          Type:
            type: STRING
            value: Diameter
          Value:
            type: FLOAT
            value: 3.0
          First:
            type: INT
            value: 0
          FirstPos:
            type: INT
            value: 0
          Second:
            type: INT
            value: -2000
          SecondPos:
            type: INT
            value: 0
          Third:
            type: INT
            value: -2000
          ThirdPos:
            type: INT
            value: 0
          Driving:
            type: BOOL
            value: true
          IsActive:
            type: BOOL
            value: true
      - kind: Constraint
        paths:
          Type:
            type: STRING
            value: DistanceY
          Value:
            type: FLOAT
            value: 10.5
          First:
            type: INT
            value: 0
          FirstPos:
            type: INT
            value: 3
          Second:
            type: INT
            value: -2000
          SecondPos:
            type: INT
            value: 0
          Third:
            type: INT
            value: -2000
          ThirdPos:
            type: INT
            value: 0
          Driving:
            type: BOOL
            value: true
          IsActive:
            type: BOOL
            value: true
      group: Sketch
    Label:
      kind: Primitive
      paths:
        .:
          type: STRING
          value: Sketch099
      group: Base
    MakeInternals:
      kind: Primitive
      paths:
        .:
          type: BOOL
          value: false
      group: Internal Geometry
    MapMode:
      kind: Primitive
      paths:
        .:
          type: STRING
          value: FlatFace
      group: Attachment
    Placement:
      kind: Placement
      paths:
        Base.x:
          type: QUANTITY
          value: 0.0 mm
        Base.y:
          type: QUANTITY
          value: 0.0 mm
        Base.z:
          type: QUANTITY
          value: 0.0 mm
        Rotation.Angle:
          type: QUANTITY
          value: 90.0 deg
        Rotation.Axis.x:
          type: FLOAT
          value: 1.0
        Rotation.Axis.y:
          type: FLOAT
          value: 0.0
        Rotation.Axis.z:
          type: FLOAT
          value: 0.0
      group: Base
- name: Sketch100
  id: 4166
  type_id: Sketcher::SketchObject
  properties:
    ArcFitTolerance:
      kind: Primitive
      paths:
        .:
          type: FLOAT
          value: 0.0
      group: Sketch
    AttacherEngine:
      kind: Primitive
      paths:
        .:
          type: STRING
          value: Engine Plane
      group: Attachment
    Constraints:
      kind: List
      paths: {}
      items:
      - kind: Constraint
        paths:
          Type:
            type: STRING
            value: PointOnObject
          Value:
            type: FLOAT
            value: 0.0
          First:
            type: INT
            value: 0
          FirstPos:
            type: INT
            value: 3
          Second:
            type: INT
            value: -2
          SecondPos:
            type: INT
            value: 0
          Third:
            type: INT
            value: -2000
          ThirdPos:
            type: INT
            value: 0
          Driving:
            type: BOOL
            value: true
          IsActive:
            type: BOOL
            value: true
      - kind: Constraint
        paths:
          Type:
            type: STRING
            value: Diameter
          Value:
            type: FLOAT
            value: 3.2
          First:
            type: INT
            value: 0
          FirstPos:
            type: INT
            value: 0
          Second:
            type: INT
            value: -2000
          SecondPos:
            type: INT
            value: 0
          Third:
            type: INT
            value: -2000
          ThirdPos:
            type: INT
            value: 0
          Driving:
            type: BOOL
            value: true
          IsActive:
            type: BOOL
            value: true
      - kind: Constraint
        paths:
          Type:
            type: STRING
            value: DistanceY
          Value:
            type: FLOAT
            value: -24.0
          First:
            type: INT
            value: 0
          FirstPos:
            type: INT
            value: 3
          Second:
            type: INT
            value: -2000
          SecondPos:
            type: INT
            value: 0
          Third:
            type: INT
            value: -2000
          ThirdPos:
            type: INT
            value: 0
          Driving:
            type: BOOL
            value: true
          IsActive:
            type: BOOL
            value: true
      group: Sketch
    Label:
      kind: Primitive
      paths:
        .:
          type: STRING
          value: Sketch100
      group: Base
    MakeInternals:
      kind: Primitive
      paths:
        .:
          type: BOOL
          value: false
      group: Internal Geometry
    MapMode:
      kind: Primitive
      paths:
        .:
          type: STRING
          value: FlatFace
      group: Attachment
    Placement:
      kind: Placement
      paths:
        Base.x:
          type: QUANTITY
          value: 0.0 mm
        Base.y:
          type: QUANTITY
          value: 0.0 mm
        Base.z:
          type: QUANTITY
          value: 0.0 mm
        Rotation.Angle:
          type: QUANTITY
          value: 90.0 deg
        Rotation.Axis.x:
          type: FLOAT
          value: 1.0
        Rotation.Axis.y:
          type: FLOAT
          value: 0.0
        Rotation.Axis.z:
          type: FLOAT
          value: 0.0
      group: Base
- name: Sketch114
  id: 4167
  type_id: Sketcher::SketchObject
  properties:
    ArcFitTolerance:
      kind: Primitive
      paths:
        .:
          type: FLOAT
          value: 0.0
      group: Sketch
    AttacherEngine:
      kind: Primitive
      paths:
        .:
          type: STRING
          value: Engine Plane
      group: Attachment
    Constraints:
      kind: List
      paths: {}
      items:
      - kind: Constraint
        paths:
          Type:
            type: STRING
            value: Coincident
          Value:
            type: FLOAT
            value: 0.0
          First:
            type: INT
            value: 1
          FirstPos:
            type: INT
            value: 1
          Second:
            type: INT
            value: 0
          SecondPos:
            type: INT
            value: 2
          Third:
            type: INT
            value: -2000
          ThirdPos:
            type: INT
            value: 0
          Driving:
            type: BOOL
            value: true
          IsActive:
            type: BOOL
            value: true
      - kind: Constraint
        paths:
          Type:
            type: STRING
            value: Vertical
          Value:
            type: FLOAT
            value: 0.0
          First:
            type: INT
            value: 1
          FirstPos:
            type: INT
            value: 0
          Second:
            type: INT
            value: -2000
          SecondPos:
            type: INT
            value: 0
          Third:
            type: INT
            value: -2000
          ThirdPos:
            type: INT
            value: 0
          Driving:
            type: BOOL
            value: true
          IsActive:
            type: BOOL
            value: true
      - kind: Constraint
        paths:
          Type:
            type: STRING
            value: Coincident
          Value:
            type: FLOAT
            value: 0.0
          First:
            type: INT
            value: 2
          FirstPos:
            type: INT
            value: 1
          Second:
            type: INT
            value: 1
          SecondPos:
            type: INT
            value: 2
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
          IsActive:
            type: BOOL
            value: true
      group: Sketch
    Label:
      kind: Primitive
      paths:
        .:
          type: STRING
          value: Sketch114
      group: Base
    MakeInternals:
      kind: Primitive
      paths:
        .:
          type: BOOL
          value: false
      group: Internal Geometry
    MapMode:
      kind: Primitive
      paths:
        .:
          type: STRING
          value: FlatFace
      group: Attachment
    Placement:
      kind: Placement
      paths:
        Base.x:
          type: QUANTITY
          value: 0.0 mm
        Base.y:
          type: QUANTITY
          value: 0.0 mm
        Base.z:
          type: QUANTITY
          value: 0.0 mm
        Rotation.Angle:
          type: QUANTITY
          value: 90.0 deg
        Rotation.Axis.x:
          type: FLOAT
          value: 1.0
        Rotation.Axis.y:
          type: FLOAT
          value: 0.0
        Rotation.Axis.z:
          type: FLOAT
          value: 0.0
      group: Base
- name: Sketch115
  id: 4168
  type_id: Sketcher::SketchObject
  properties:
    ArcFitTolerance:
      kind: Primitive
      paths:
        .:
          type: FLOAT
          value: 0.0
      group: Sketch
    AttacherEngine:
      kind: Primitive
      paths:
        .:
          type: STRING
          value: Engine Plane
      group: Attachment
    Constraints:
      kind: List
      paths: {}
      items:
      - kind: Constraint
        paths:
          Type:
            type: STRING
            value: Horizontal
          Value:
            type: FLOAT
            value: 0.0
          First:
            type: INT
            value: 0
          FirstPos:
            type: INT
            value: 0
          Second:
            type: INT
            value: -2000
          SecondPos:
            type: INT
            value: 0
          Third:
            type: INT
            value: -2000
          ThirdPos:
            type: INT
            value: 0
          Driving:
            type: BOOL
            value: true
          IsActive:
            type: BOOL
            value: true
      - kind: Constraint
        paths:
          Type:
            type: STRING
            value: Coincident
          Value:
            type: FLOAT
            value: 0.0
          First:
            type: INT
            value: 1
          FirstPos:
            type: INT
            value: 1
          Second:
            type: INT
            value: 0
          SecondPos:
            type: INT
            value: 2
          Third:
            type: INT
            value: -2000
          ThirdPos:
            type: INT
            value: 0
          Driving:
            type: BOOL
            value: true
          IsActive:
            type: BOOL
            value: true
      - kind: Constraint
        paths:
          Type:
            type: STRING
            value: Vertical
          Value:
            type: FLOAT
            value: 0.0
          First:
            type: INT
            value: 1
          FirstPos:
            type: INT
            value: 0
          Second:
            type: INT
            value: -2000
          SecondPos:
            type: INT
            value: 0
          Third:
            type: INT
            value: -2000
          ThirdPos:
            type: INT
            value: 0
          Driving:
            type: BOOL
            value: true
          IsActive:
            type: BOOL
            value: true
      - kind: Constraint
        paths:
          Type:
            type: STRING
            value: PointOnObject
          Value:
            type: FLOAT
            value: 0.0
          First:
            type: INT
            value: 2
          FirstPos:
            type: INT
            value: 3
          Second:
            type: INT
            value: 0
          SecondPos:
            type: INT
            value: 0
          Third:
            type: INT
            value: -2000
          ThirdPos:
            type: INT
            value: 0
          Driving:
            type: BOOL
            value: true
          IsActive:
            type: BOOL
            value: true
      - kind: Constraint
        paths:
          Type:
            type: STRING
            value: Coincident
          Value:
            type: FLOAT
            value: 0.0
          First:
            type: INT
            value: 2
          FirstPos:
            type: INT
            value: 2
          Second:
            type: INT
            value: 0
          SecondPos:
            type: INT
            value: 1
          Third:
            type: INT
            value: -2000
          ThirdPos:
            type: INT
            value: 0
          Driving:
            type: BOOL
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
      - kind: Constraint
        paths:
          Type:
            type: STRING
            value: Vertical
          Value:
            type: FLOAT
            value: 0.0
          First:
            type: INT
            value: 5
          FirstPos:
            type: INT
            value: 0
          Second:
            type: INT
            value: -2000
          SecondPos:
            type: INT
            value: 0
          Third:
            type: INT
            value: -2000
          ThirdPos:
            type: INT
            value: 0
          Driving:
            type: BOOL
            value: true
          IsActive:
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
