Barbatronic/Omni-RC-Robot/(commit log)

2026-08-29 init history project
    [motor-hub.FCStd, omni-wheel.FCStd]
2026-08-30 motor flange and wheel
    [motor-36GP-555.FCStd, motor-hub.FCStd, motor-hub.yaml, omni-rc-robot.FCStd, omni-wheel.FCStd, propulsion-arm-asm.FCStd]
2026-09-04 first version mobil base
    [battery.FCStd, motor-36GP-555.FCStd, omni-rc-robot.FCStd, propulsion-arm-asm.FCStd, support-BTS7960B.FCStd]
2026-09-10 Firmware ESP32-S3 du robot omnidirectionnel
    Firmware complet pour un robot RC omnidirectionnel a 4 roues : reception
    radio, mixage parametrique, pilotage des BTS7960 et interface Web embarquee.
    Architecture
    Boucle de controle a 200 Hz sur une tache dediee du coeur 1, serveur Web
    asynchrone sur le coeur 0. La tache de controle demarre AVANT le reseau :
    l'initialisation Wi-Fi peut prendre une vingtaine de secondes quand le
    reseau configure est absent, et le robot doit repondre a la radiocommande
    bien avant.
    Radiocommande
    SBUS et iBUS, reconnus automatiquement au demarrage. Le FlySky FS-iA6B
    utilise pour la mise au point ne sort pas de SBUS mais de l'iBUS ; les deux
    protocoles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
2026-09-10 CAD update - First POC
    [aru-asm.FCStd, propulsion-arm-asm.FCStd]
2026-09-12 ecad reflexion
    [omni-board.kicad_pcb, omni-board.kicad_sch]
2026-09-12 update for production
    [omni-board.kicad_pcb, omni-board.kicad_sch]
2026-09-12 sbus connector added
    [omni-board.kicad_pcb, omni-board.kicad_sch]
2026-09-13 update silkscreen
    [omni-board.kicad_pcb]
2026-09-16 add I2C connector
    [omni-board.kicad_pcb, omni-board.kicad_sch]
2026-09-16 ESP32-S3 zero compatibility
2026-09-18 fix save and parameters
    [web_interface.cpp]
2026-09-18 new flat power hub
    [aru-asm.FCStd]
2026-10-29 add PCB support
